Dritzz7/hardware-dosimeter/jlcpcb/WBV_20261011_R2/WBV_JLC_BOM.csv

Comment | Designator | Footprint | LCSC Part #
1060TR | BT1 | BatteryHolder_Keystone_1060TR_1x2032 | C238069
CL31A226KOHNNNE | C1 | C_1206_3216Metric | C90146
C0805C104K5RACTU | C2,C4,C5,C7,C10,C11,C12,C13,C14,C16,C18,C20,C21,C22,C24 | C_0805_2012Metric | C3018562
C0805C105K4RACTU | C3,C6 | C_0805_2012Metric | C2167376
CL21A106KAYNNNE | C8,C15,C23 | C_0805_2012Metric | C15850
EEUFR1E470 | C17,C19 | CP_Radial_D5.0mm_P2.00mm_H11mm_Panasonic_FR | C407893
USBLC6-4SC6 | D1,D2,D3 | SOT-23-6_USBLC6-4SC6_ST | C111212
MF-MSMF075-2 | F1 | Fuse_Bourns_MF-MSMF075_1812_Style1 | C84140
BLM21PG601SN1D | FB1 | L_0805_2012Metric | C41556732
2.54-1*6 | J1 | PinHeader_1x06_P2.54mm_ZHOURI_1.02mm | C5156615
DM3CS-SF | J2 | microSD_Hirose_DM3CS-SF | C202111
B4B-XH-A(LF)(SN) | J3,J5 | JST_XH_B4B-XH-A_1x04_P2.50mm_Vertical | C144395
B2B-XH-A(LF)(SN) | J4 | JST_XH_B2B-XH-A_1x02_P2.50mm_Vertical | C158012
RC0805FR-0710KL | R1,R2,R11,R12,R13,R14,R15,R16,R19 | R_0805_2012Metric | C84376
RC0805FR-07499RL | R3 | R_0805_2012Metric | C130458
RC0805FR-0733RL | R8,R9,R10 | R_0805_2012Metric | C126353
RC0805FR-074K7L | R17,R18 | R_0805_2012Metric | C60816
RC0805FR-071KL | R20 | R_0805_2012Metric | C95781
RC0805FR-07330KL | R21 | R_0805_2012Metric | C114528
RC0805FR-07100KL | R22 | R_0805_2012Metric | C96346
B3F-1000 | SW1,SW2,SW3 | SW_PUSH_6mm_H4.3mm | C93157
ESP32-WROOM-32E-N4 | U1 | ESP32-WROOM-32E_JLC_NoVia | C701341
ADXL345BCCZ-RL7 | U2 | ADXL345_CC-14-1_ADI_JLC | C9667
DS3231SN# | U3 | SOIC-16W_7.5x10.3mm_P1.27mm | C5369307
