Dritzz7/hardware-dosimeter/jlcpcb/WBV_20261011_R2/WBV_Assembly_Top.png

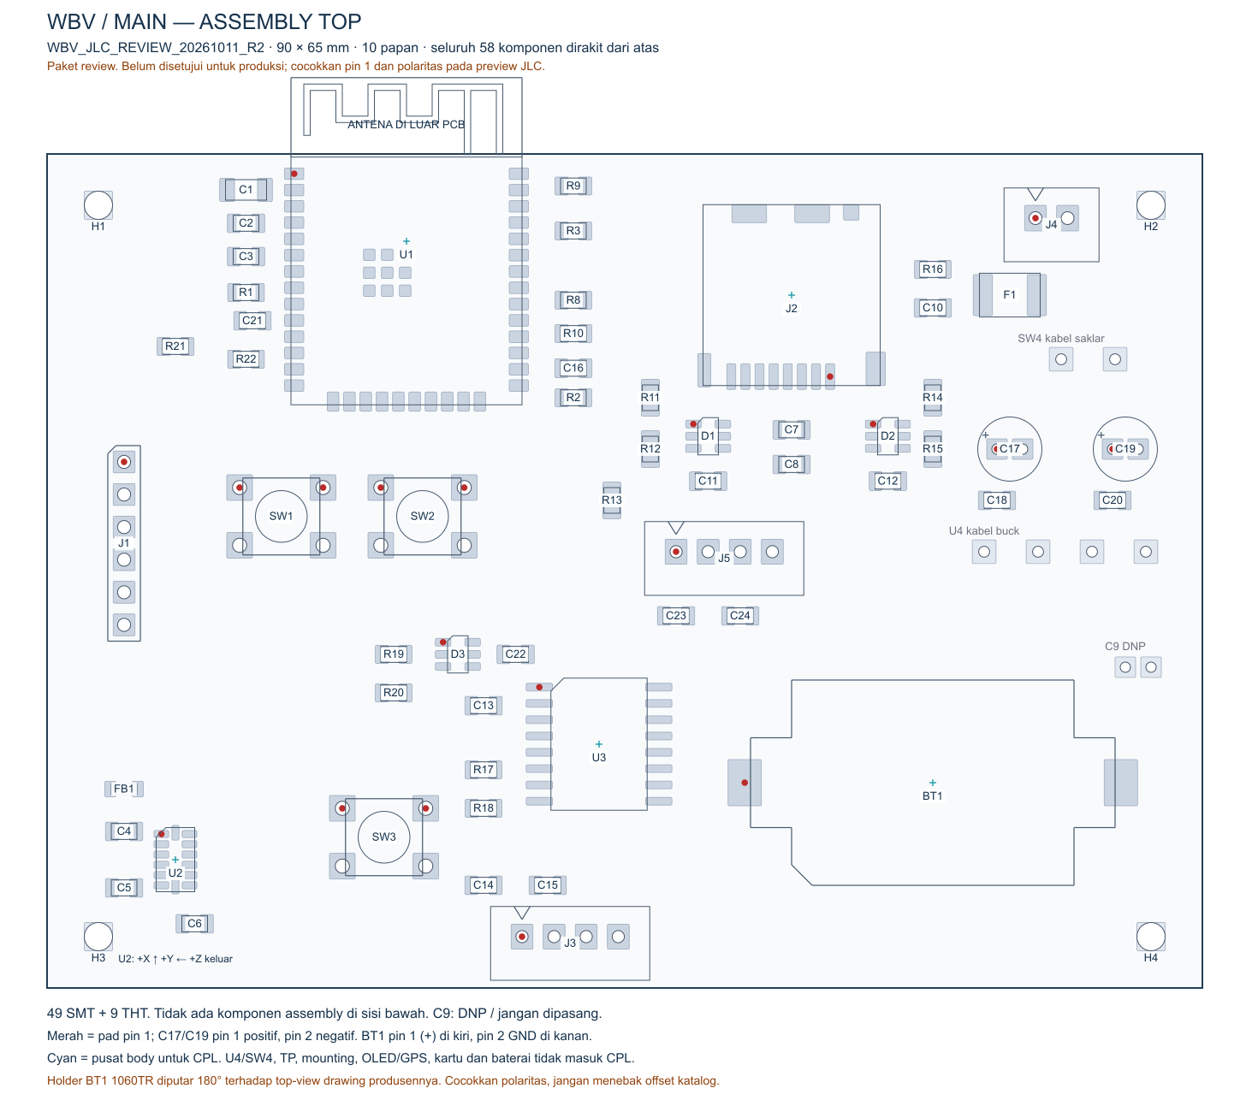
jlcpcb/WBV_20261011_R2/WBV_Assembly_Top.png
