Dritzz7/hardware-dosimeter/main_unit/main_unit.kicad_pcb

## KiCad design main_unit/main_unit.kicad_pcb (2026-10-11)

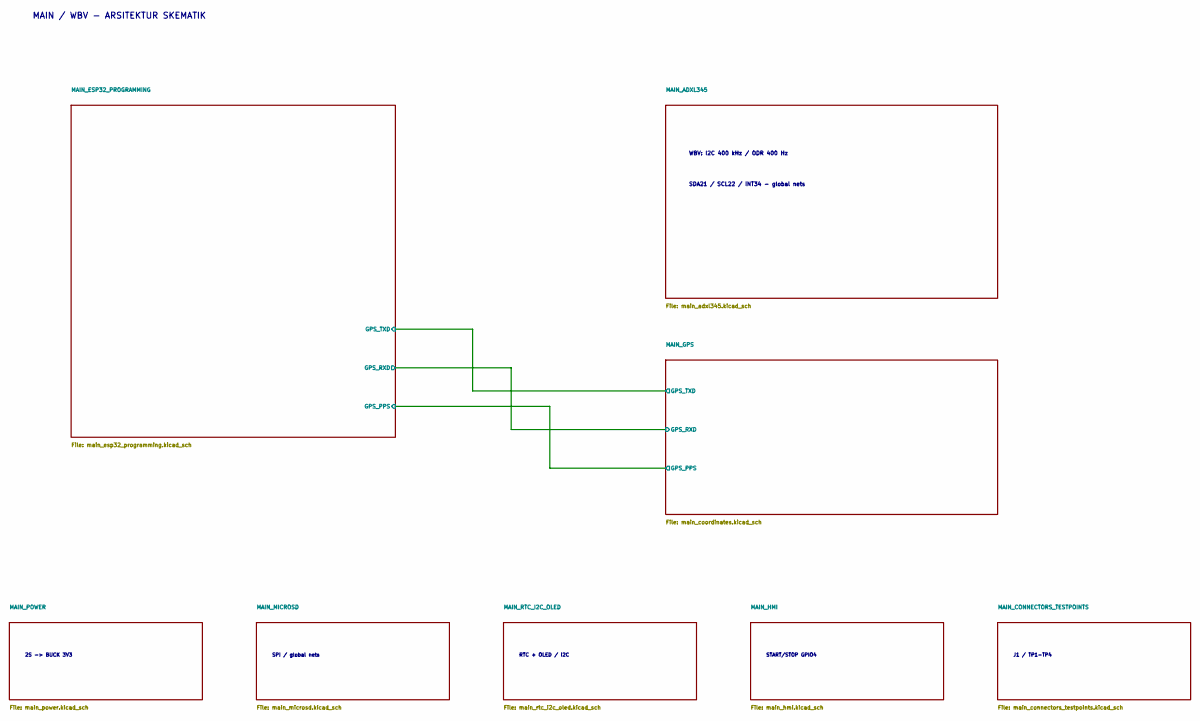
[picture p2: schematic main_unit.kicad_sch, MAIN ROOT - WBV + GPS]

Notes on the sheet:
2S -> BUCK 3V3
MAIN / WBV - ARSITEKTUR SKEMATIK
SPI / global nets
RTC + OLED / I2C
WBV: I2C 400 kHz / ODR 400 Hz
START/STOP GPIO4
SDA21 / SCL22 / INT34 - global nets
J1 / TP1-TP4

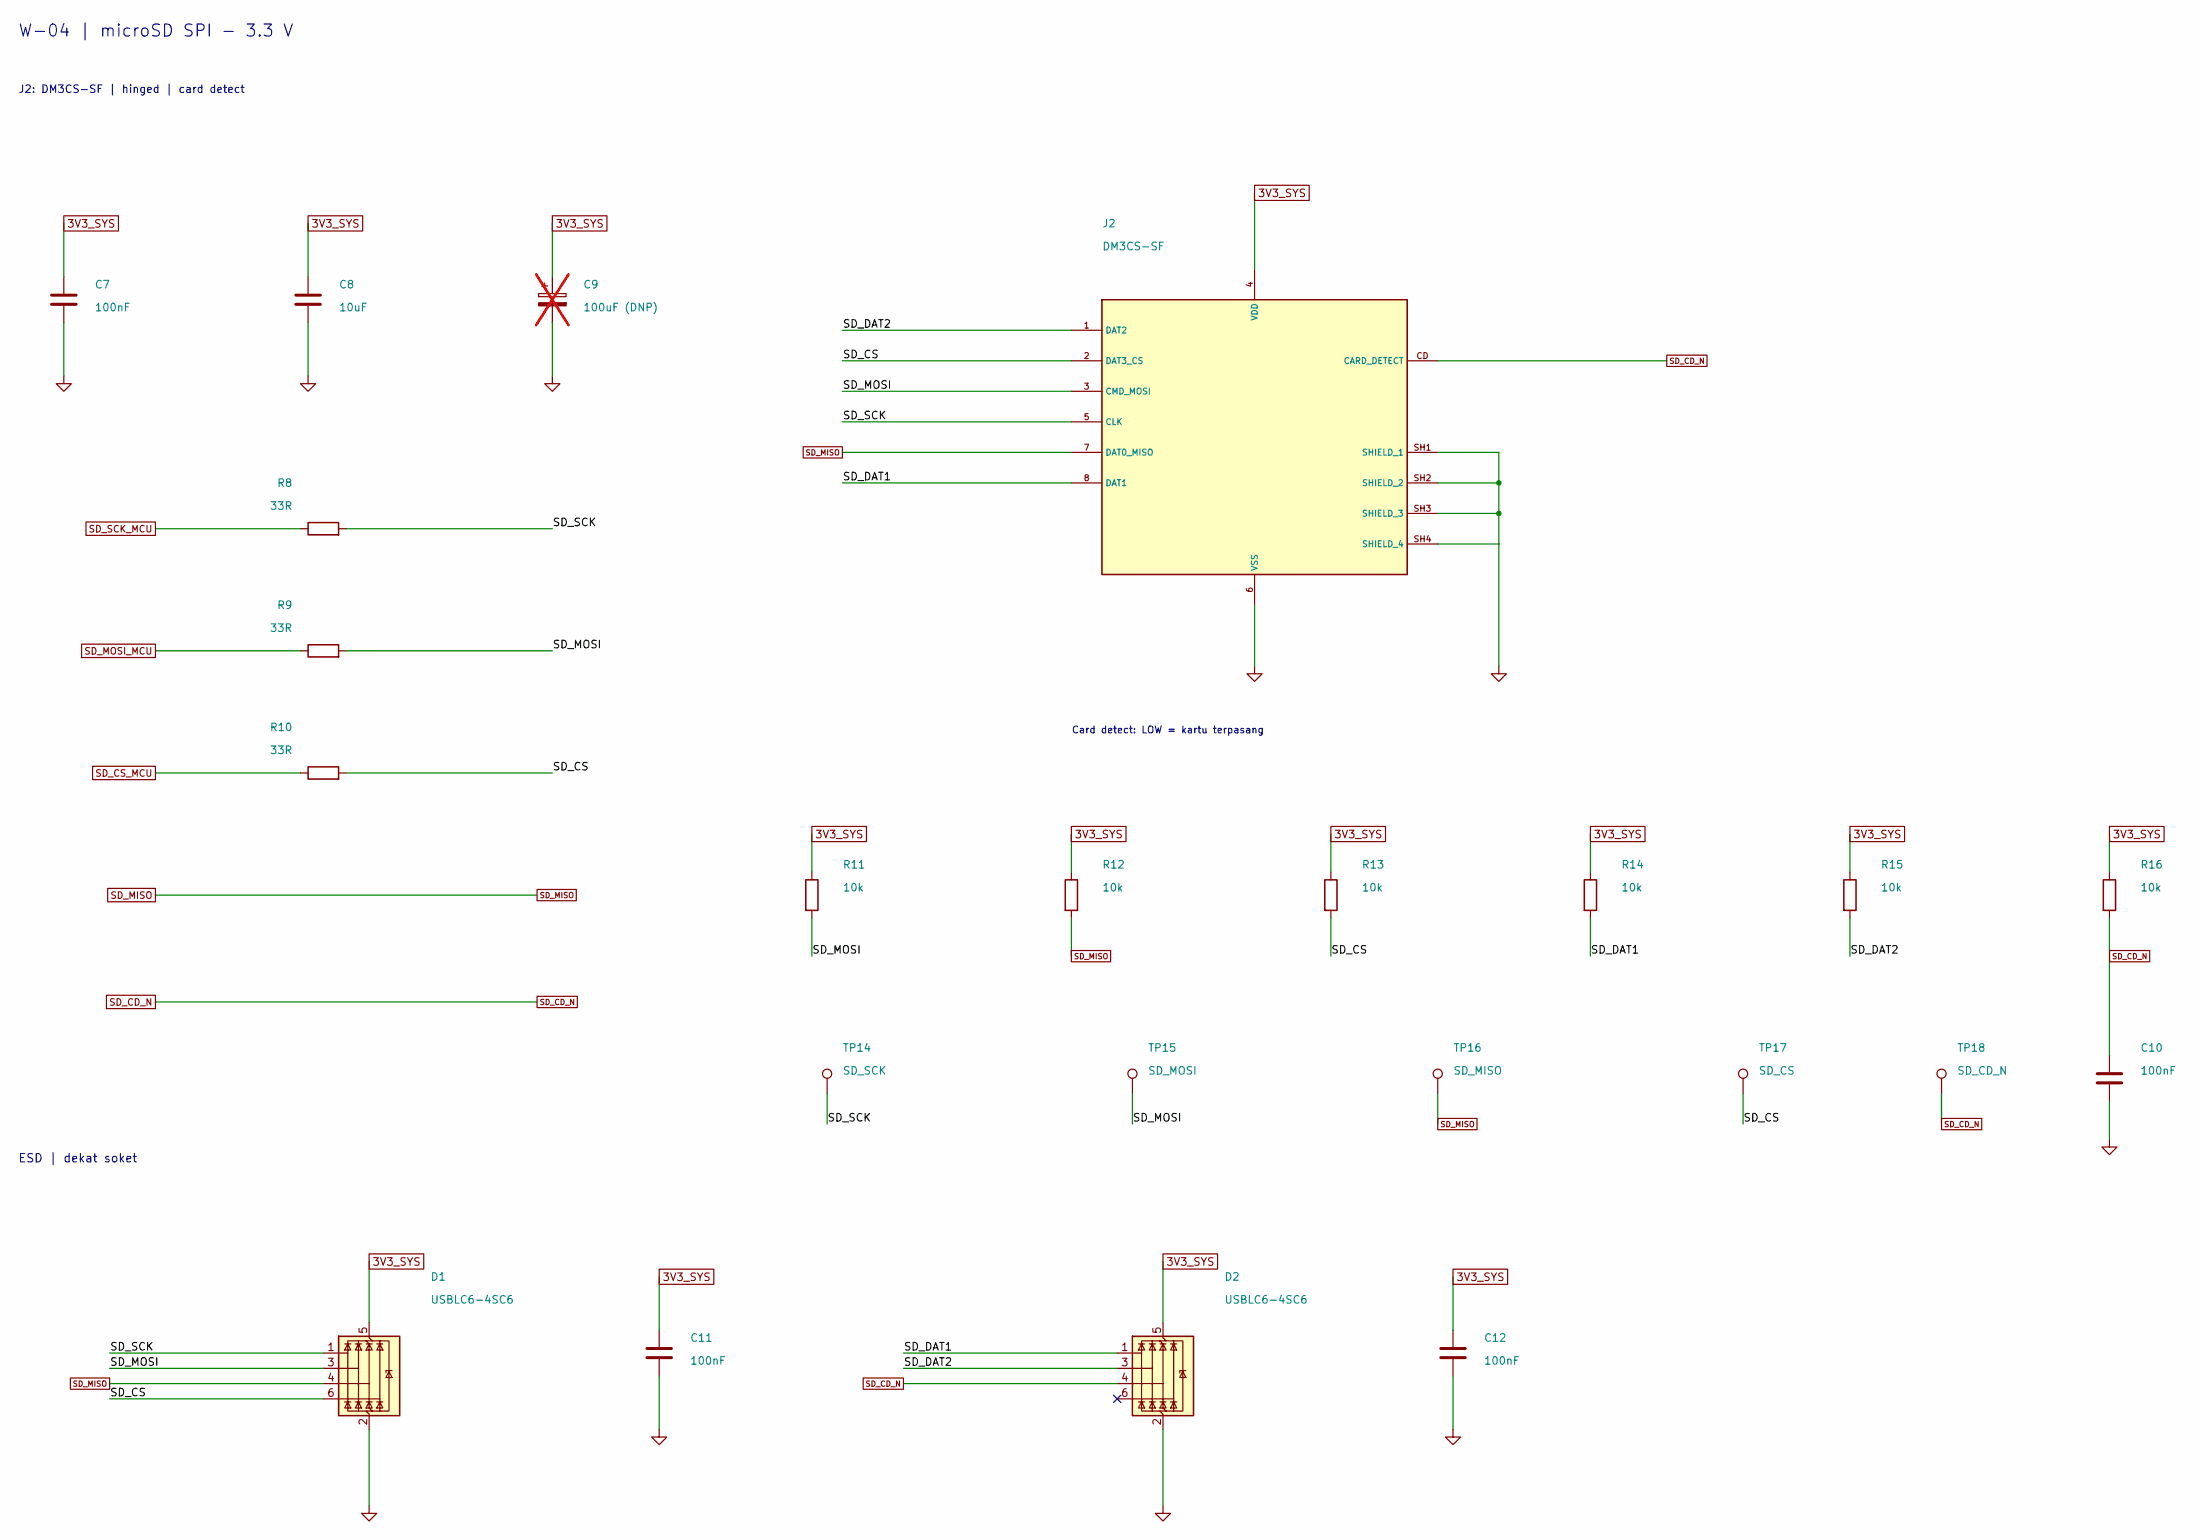
[picture p3: schematic main_microsd.kicad_sch, MAIN microSD - SPI]

Parts:
C7, C10, C11, C12: 100nF; C_0805_2012Metric; MPN C0805C104K5RACTU; LCSC Part # C3018562
C8: 10uF; C_0805_2012Metric; MPN CL21A106KAYNNNE; LCSC Part # C15850
C9: 100uF (DNP); CP_Radial_D5.0mm_P2.00mm_H11mm_Panasonic_FR; MPN EEUFR1C101; not fitted
D1, D2: USBLC6-4SC6; SOT-23-6_USBLC6-4SC6_ST; MPN USBLC6-4SC6; LCSC Part # C111212
J2: DM3CS-SF; microSD_Hirose_DM3CS-SF; MPN DM3CS-SF; LCSC Part # C202111
R8, R9, R10: 33R; R_0805_2012Metric; MPN RC0805FR-0733RL; LCSC Part # C126353
R11, R12, R13, R14, R15, R16: 10k; R_0805_2012Metric; MPN RC0805FR-0710KL; LCSC Part # C84376
TP14: SD_SCK; TestPoint_Pad_D1.5mm; MPN N/A - PCB copper feature
TP15: SD_MOSI; TestPoint_Pad_D1.5mm; MPN N/A - PCB copper feature
TP16: SD_MISO; TestPoint_Pad_D1.5mm; MPN N/A - PCB copper feature
TP17: SD_CS; TestPoint_Pad_D1.5mm; MPN N/A - PCB copper feature
TP18: SD_CD_N; TestPoint_Pad_D1.5mm; MPN N/A - PCB copper feature

Connections:
3V3_SYS: C7.1, C8.1, C9.1, C11.1, C12.1, D1.5 (VBUS), D2.5 (VBUS), J2.4 (VDD), R11.1, R12.1, R13.1, R14.1, R15.1, R16.1; also elsewhere on the board
/MAIN_MICROSD/SD_CS: D1.6 (I/O4), J2.2 (DAT3_CS), R10.2, R13.2, TP17.1 (1_1)
/MAIN_MICROSD/SD_DAT1: D2.1 (I/O1), J2.8 (DAT1), R14.2
/MAIN_MICROSD/SD_DAT2: D2.3 (I/O2), J2.1 (DAT2), R15.2
/MAIN_MICROSD/SD_MOSI: D1.3 (I/O2), J2.3 (CMD_MOSI), R9.2, R11.2, TP15.1 (1_1)
/MAIN_MICROSD/SD_SCK: D1.1 (I/O1), J2.5 (CLK), R8.2, TP14.1 (1_1)
GND: C7.2, C8.2, C9.2, C10.2, C11.2, C12.2, D1.2 (GND), D2.2 (GND), J2.6 (VSS), J2.SH1 (SHIELD_1), J2.SH2 (SHIELD_2), J2.SH3 (SHIELD_3), J2.SH4 (SHIELD_4); also elsewhere on the board
SD_CD_N: C10.1, D2.4 (I/O3), J2.CD (CARD_DETECT), R16.2, TP18.1 (1_1); also elsewhere on the board
SD_CS_MCU: R10.1; also elsewhere on the board
SD_MISO: D1.4 (I/O3), J2.7 (DAT0_MISO), R12.2, TP16.1 (1_1); also elsewhere on the board
SD_MOSI_MCU: R9.1; also elsewhere on the board
SD_SCK_MCU: R8.1; also elsewhere on the board

Notes on the sheet:
Card detect: LOW = kartu terpasang
ESD | dekat soket
W-04 | microSD SPI - 3.3 V
J2: DM3CS-SF | hinged | card detect

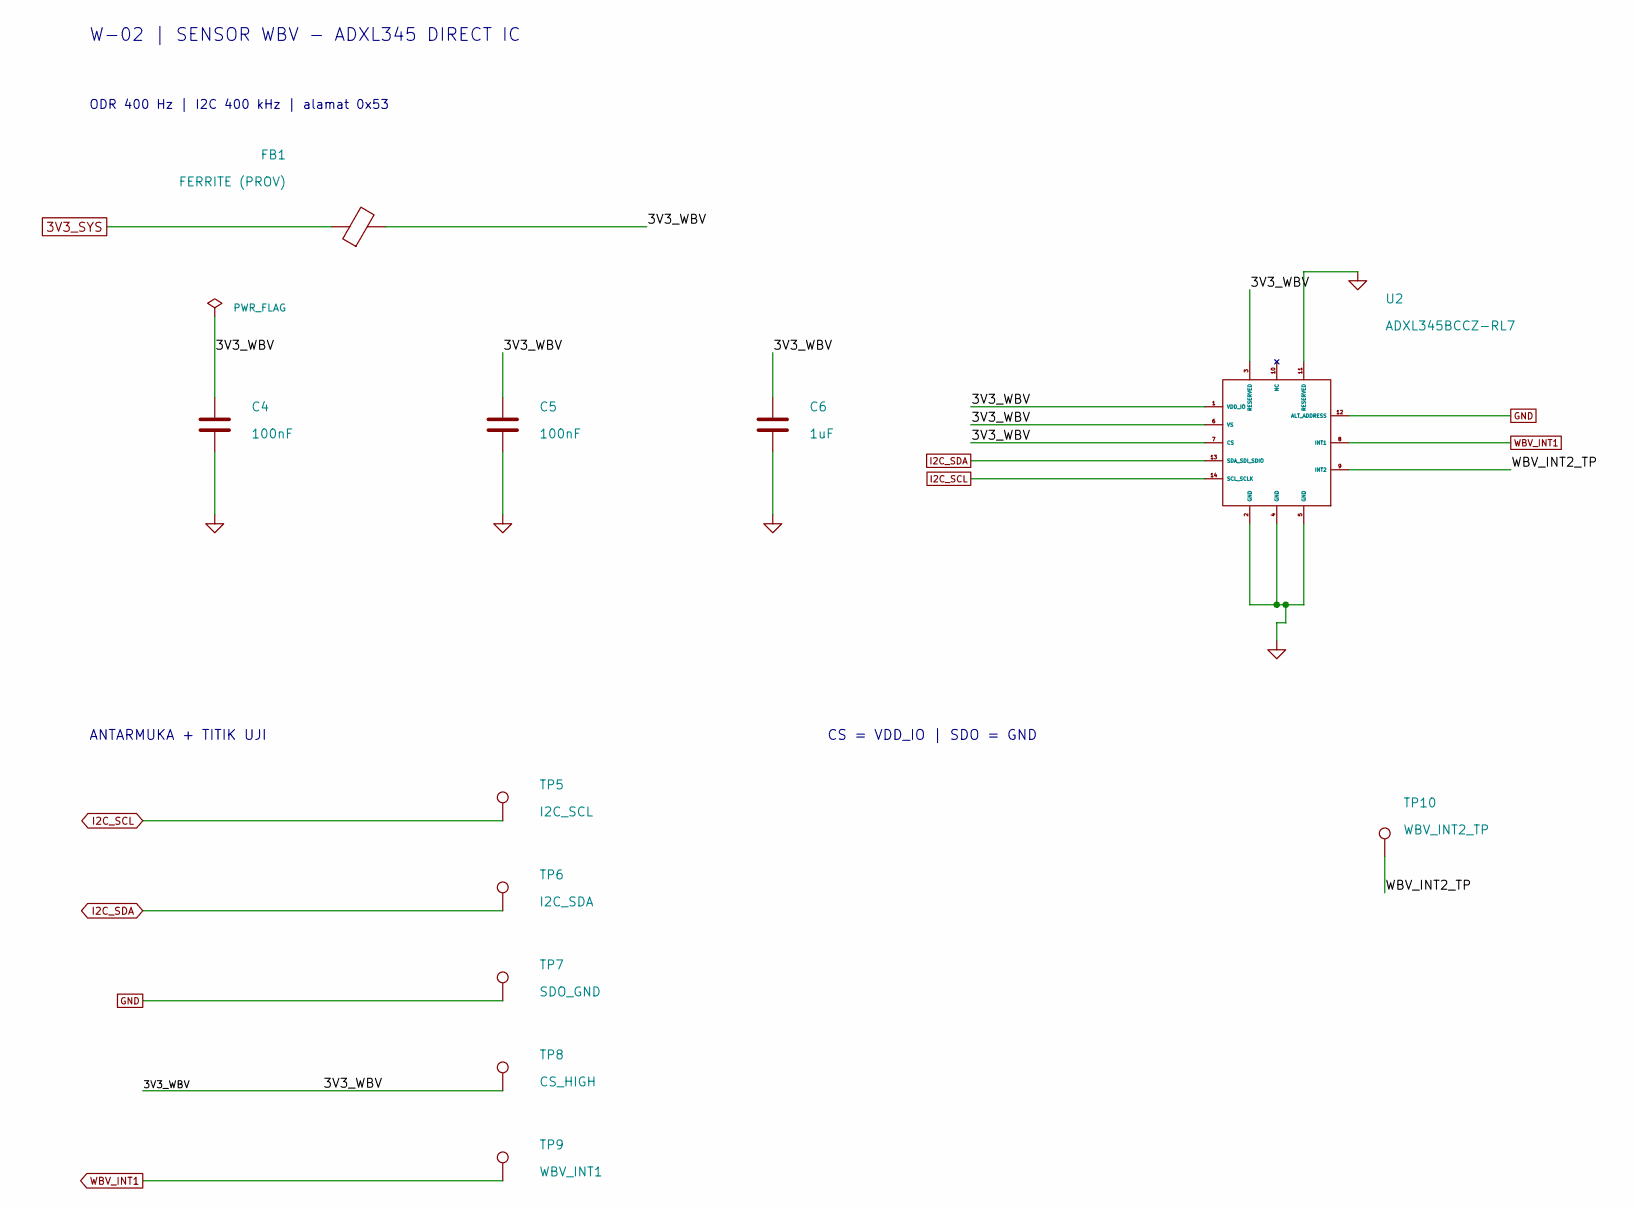
[picture p4: schematic main_adxl345.kicad_sch, MAIN WBV - ADXL345 400 Hz]

Parts:
C4, C5: 100nF; C_0805_2012Metric; MPN C0805C104K5RACTU; LCSC Part # C3018562
C6: 1uF; C_0805_2012Metric; MPN C0805C105K4RACTU; LCSC Part # C2167376
FB1: FERRITE (PROV); L_0805_2012Metric; MPN BLM21PG601SN1D; LCSC Part # C41556732
TP5: I2C_SCL; TestPoint_Pad_D1.5mm; MPN N/A - PCB copper feature
TP6: I2C_SDA; TestPoint_Pad_D1.5mm; MPN N/A - PCB copper feature
TP7: SDO_GND; TestPoint_Pad_D1.5mm; MPN N/A - PCB copper feature
TP8: CS_HIGH; TestPoint_Pad_D1.5mm; MPN N/A - PCB copper feature
TP9: WBV_INT1; TestPoint_Pad_D1.5mm; MPN N/A - PCB copper feature
TP10: WBV_INT2_TP; TestPoint_Pad_D1.5mm; MPN N/A - PCB copper feature
U2: ADXL345BCCZ-RL7; ADXL345_CC-14-1_ADI_JLC; MPN ADXL345BCCZ-RL7; LCSC Part # C9667

Connections:
3V3_SYS: FB1.1; also elsewhere on the board
/MAIN_ADXL345/3V3_WBV: C4.1, C5.1, C6.1, FB1.2, TP8.1 (1_1), U2.1 (VDD_IO), U2.3 (RESERVED), U2.6 (VS), U2.7 (CS)
/MAIN_ADXL345/WBV_INT2_TP: TP10.1 (1_1), U2.9 (INT2)
GND: C4.2, C5.2, C6.2, TP7.1 (1_1), U2.2 (GND), U2.4 (GND), U2.5 (GND), U2.11 (RESERVED), U2.12 (ALT_ADDRESS); also elsewhere on the board
I2C_SCL: TP5.1 (1_1), U2.14 (SCL_SCLK); also elsewhere on the board
I2C_SDA: TP6.1 (1_1), U2.13 (SDA_SDI_SDIO); also elsewhere on the board
WBV_INT1: TP9.1 (1_1), U2.8 (INT1); also elsewhere on the board

Notes on the sheet:
W-02 | SENSOR WBV - ADXL345 DIRECT IC
ODR 400 Hz | I2C 400 kHz | alamat 0x53
ANTARMUKA + TITIK UJI
CS = VDD_IO | SDO = GND

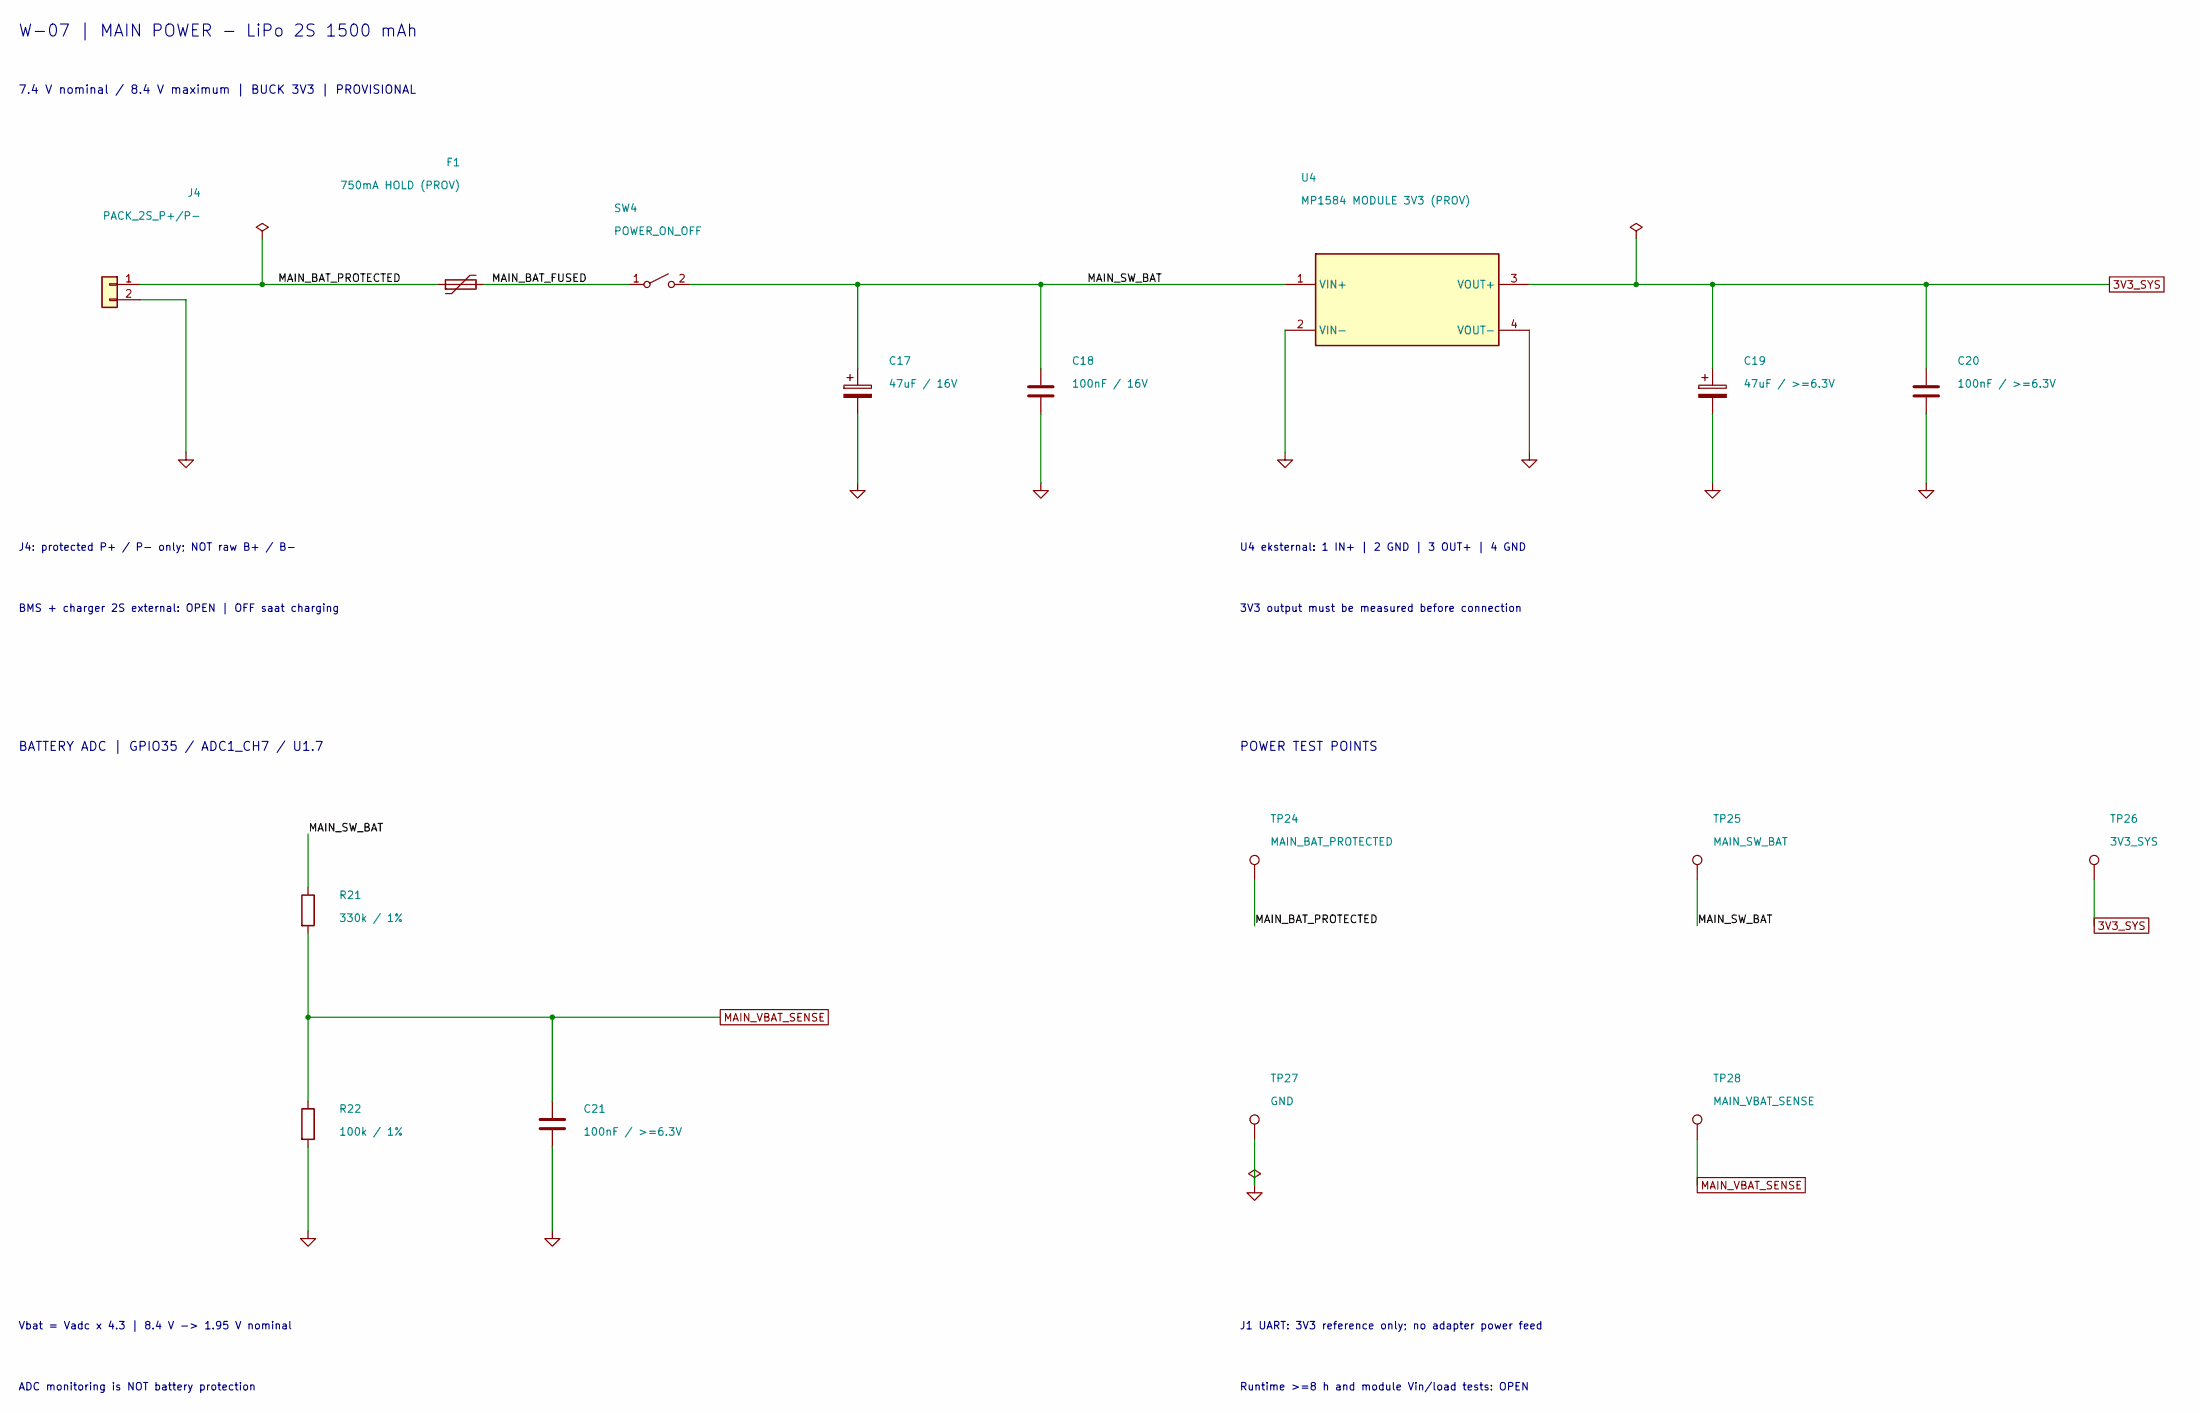
[picture p5: schematic main_power.kicad_sch, MAIN POWER - 2S BUCK]

Parts:
C17: 47uF / 16V; CP_Radial_D5.0mm_P2.00mm_H11mm_Panasonic_FR; MPN EEUFR1E470; LCSC Part # C407893
C18: 100nF / 16V; C_0805_2012Metric; MPN C0805C104K5RACTU; LCSC Part # C3018562
C19: 47uF / >=6.3V; CP_Radial_D5.0mm_P2.00mm_H11mm_Panasonic_FR; MPN EEUFR1E470; LCSC Part # C407893
C20, C21: 100nF / >=6.3V; C_0805_2012Metric; MPN C0805C104K5RACTU; LCSC Part # C3018562
F1: 750mA HOLD (PROV); Fuse_Bourns_MF-MSMF075_1812_Style1; MPN MF-MSMF075-2; LCSC Part # C84140
J4: PACK_2S_P+/P-; JST_XH_B2B-XH-A_1x02_P2.50mm_Vertical; MPN B2B-XH-A(LF)(SN); LCSC Part # C158012
R21: 330k / 1%; R_0805_2012Metric; MPN RC0805FR-07330KL; LCSC Part # C114528
R22: 100k / 1%; R_0805_2012Metric; MPN RC0805FR-07100KL; LCSC Part # C96346
SW4: POWER_ON_OFF; SolderWire-0.25sqmm_1x02_P4.2mm_D0.65mm_OD1.7mm; MPN OPEN - verify purchased part
TP24: MAIN_BAT_PROTECTED; TestPoint_Pad_D1.5mm; MPN N/A - PCB copper feature
TP25: MAIN_SW_BAT; TestPoint_Pad_D1.5mm; MPN N/A - PCB copper feature
TP26: 3V3_SYS; TestPoint_Pad_D1.5mm; MPN N/A - PCB copper feature
TP27: GND; TestPoint_Pad_D1.5mm; MPN N/A - PCB copper feature
TP28: MAIN_VBAT_SENSE; TestPoint_Pad_D1.5mm; MPN N/A - PCB copper feature
U4: MP1584 MODULE 3V3 (PROV); SolderWire-0.25sqmm_1x04_P4.2mm_D0.65mm_OD1.7mm; MPN OPEN - verify purchased part

Connections:
3V3_SYS: C19.1, C20.1, TP26.1 (1_1), U4.3 (VOUT+); also elsewhere on the board
/MAIN_POWER/MAIN_BAT_FUSED: F1.2, SW4.1 (A)
/MAIN_POWER/MAIN_BAT_PROTECTED: F1.1, J4.1, TP24.1 (1_1)
/MAIN_POWER/MAIN_SW_BAT: C17.1, C18.1, R21.1, SW4.2 (B), TP25.1 (1_1), U4.1 (VIN+)
GND: C17.2, C18.2, C19.2, C20.2, C21.2, J4.2, R22.2, TP27.1 (1_1), U4.2 (VIN-), U4.4 (VOUT-); also elsewhere on the board
MAIN_VBAT_SENSE: C21.1, R21.2, R22.1, TP28.1 (1_1); also elsewhere on the board

Notes on the sheet:
ADC monitoring is NOT battery protection
POWER TEST POINTS
Vbat = Vadc x 4.3 | 8.4 V -> 1.95 V nominal
Runtime >=8 h and module Vin/load tests: OPEN
J1 UART: 3V3 reference only; no adapter power feed
3V3 output must be measured before connection
U4 eksternal: 1 IN+ | 2 GND | 3 OUT+ | 4 GND
J4: protected P+ / P- only; NOT raw B+ / B-
7.4 V nominal / 8.4 V maximum | BUCK 3V3 | PROVISIONAL
BMS + charger 2S external: OPEN | OFF saat charging
W-07 | MAIN POWER - LiPo 2S 1500 mAh
BATTERY ADC | GPIO35 / ADC1_CH7 / U1.7

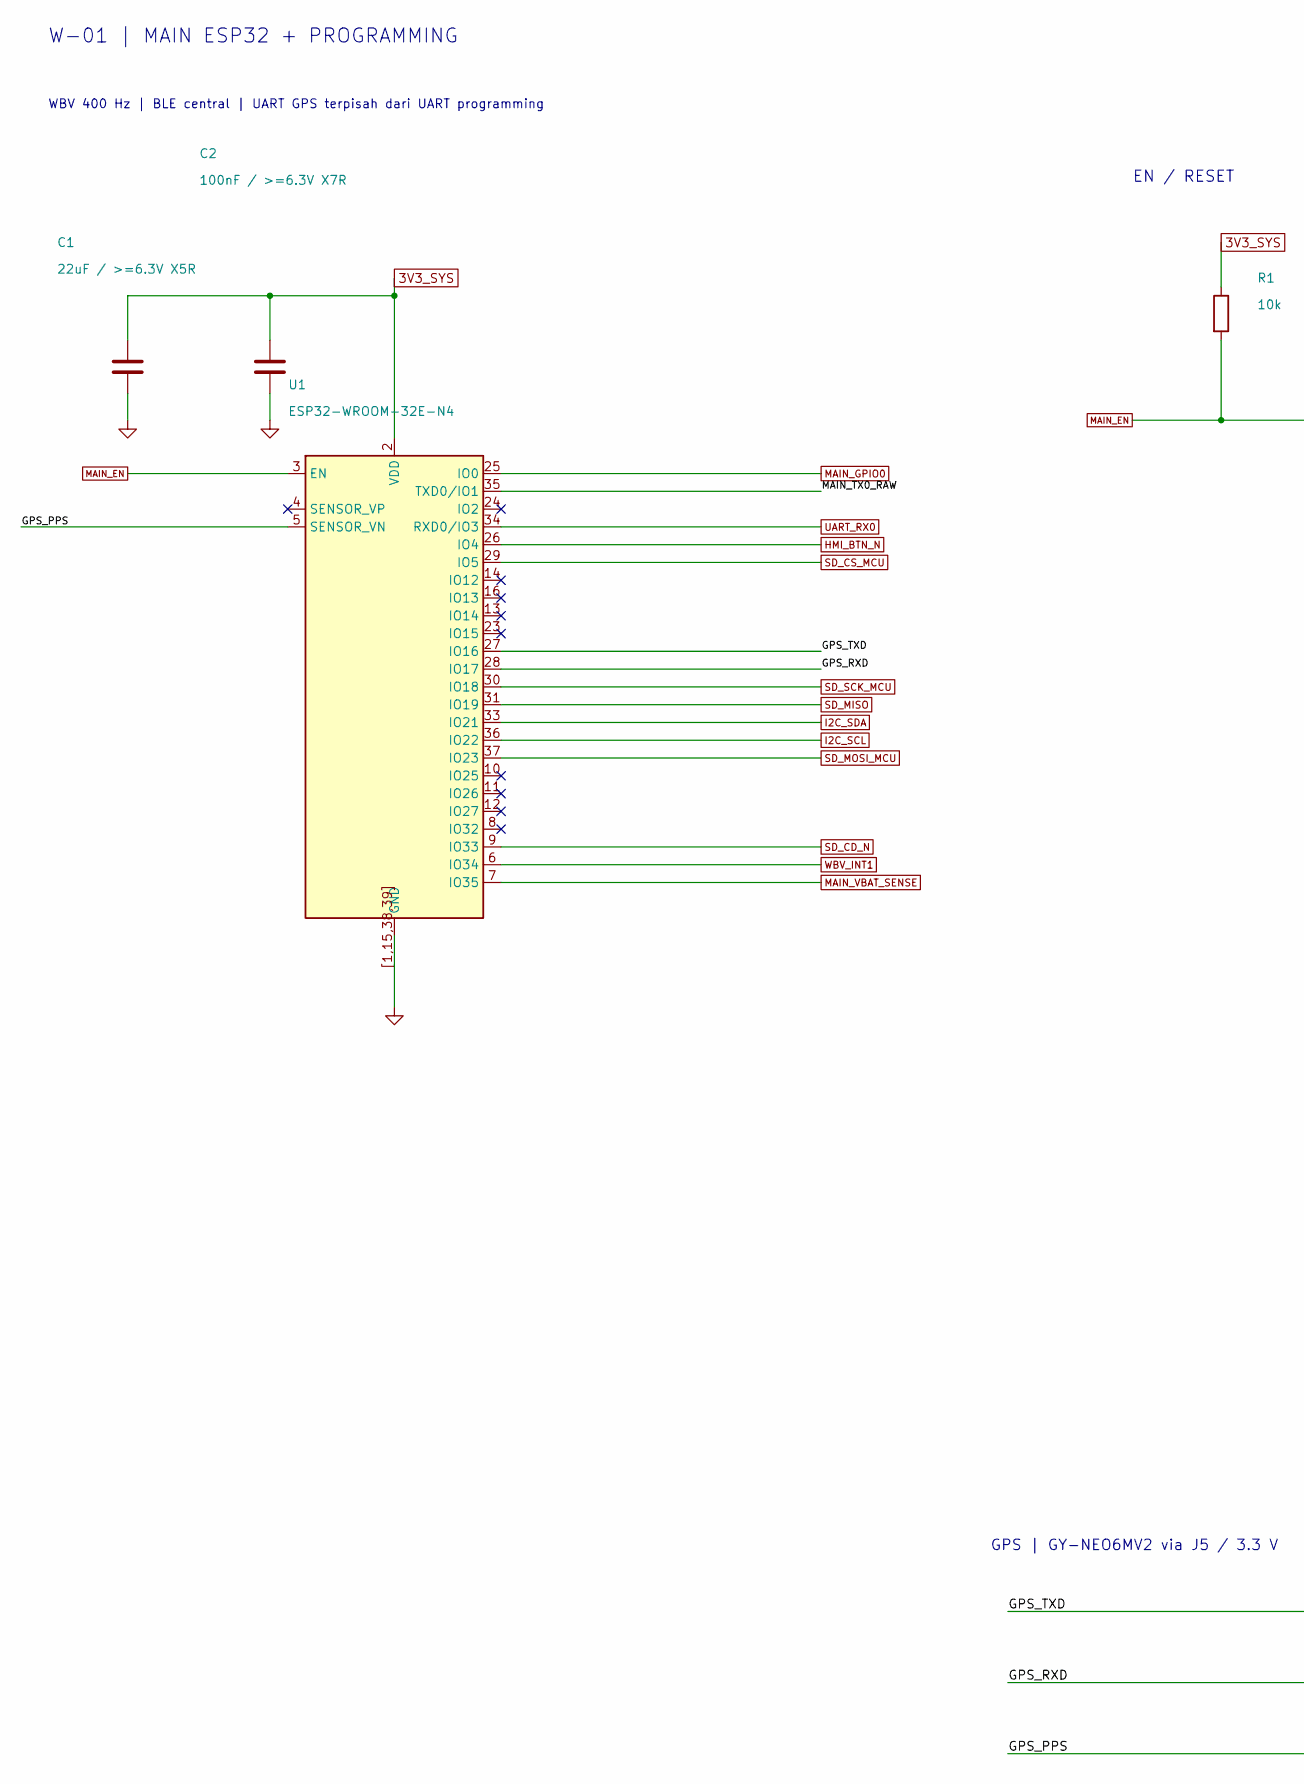
[picture p6: schematic main_esp32_programming.kicad_sch, MAIN ESP32 - RESET - BOOT - UART, part in row 1, column 1]

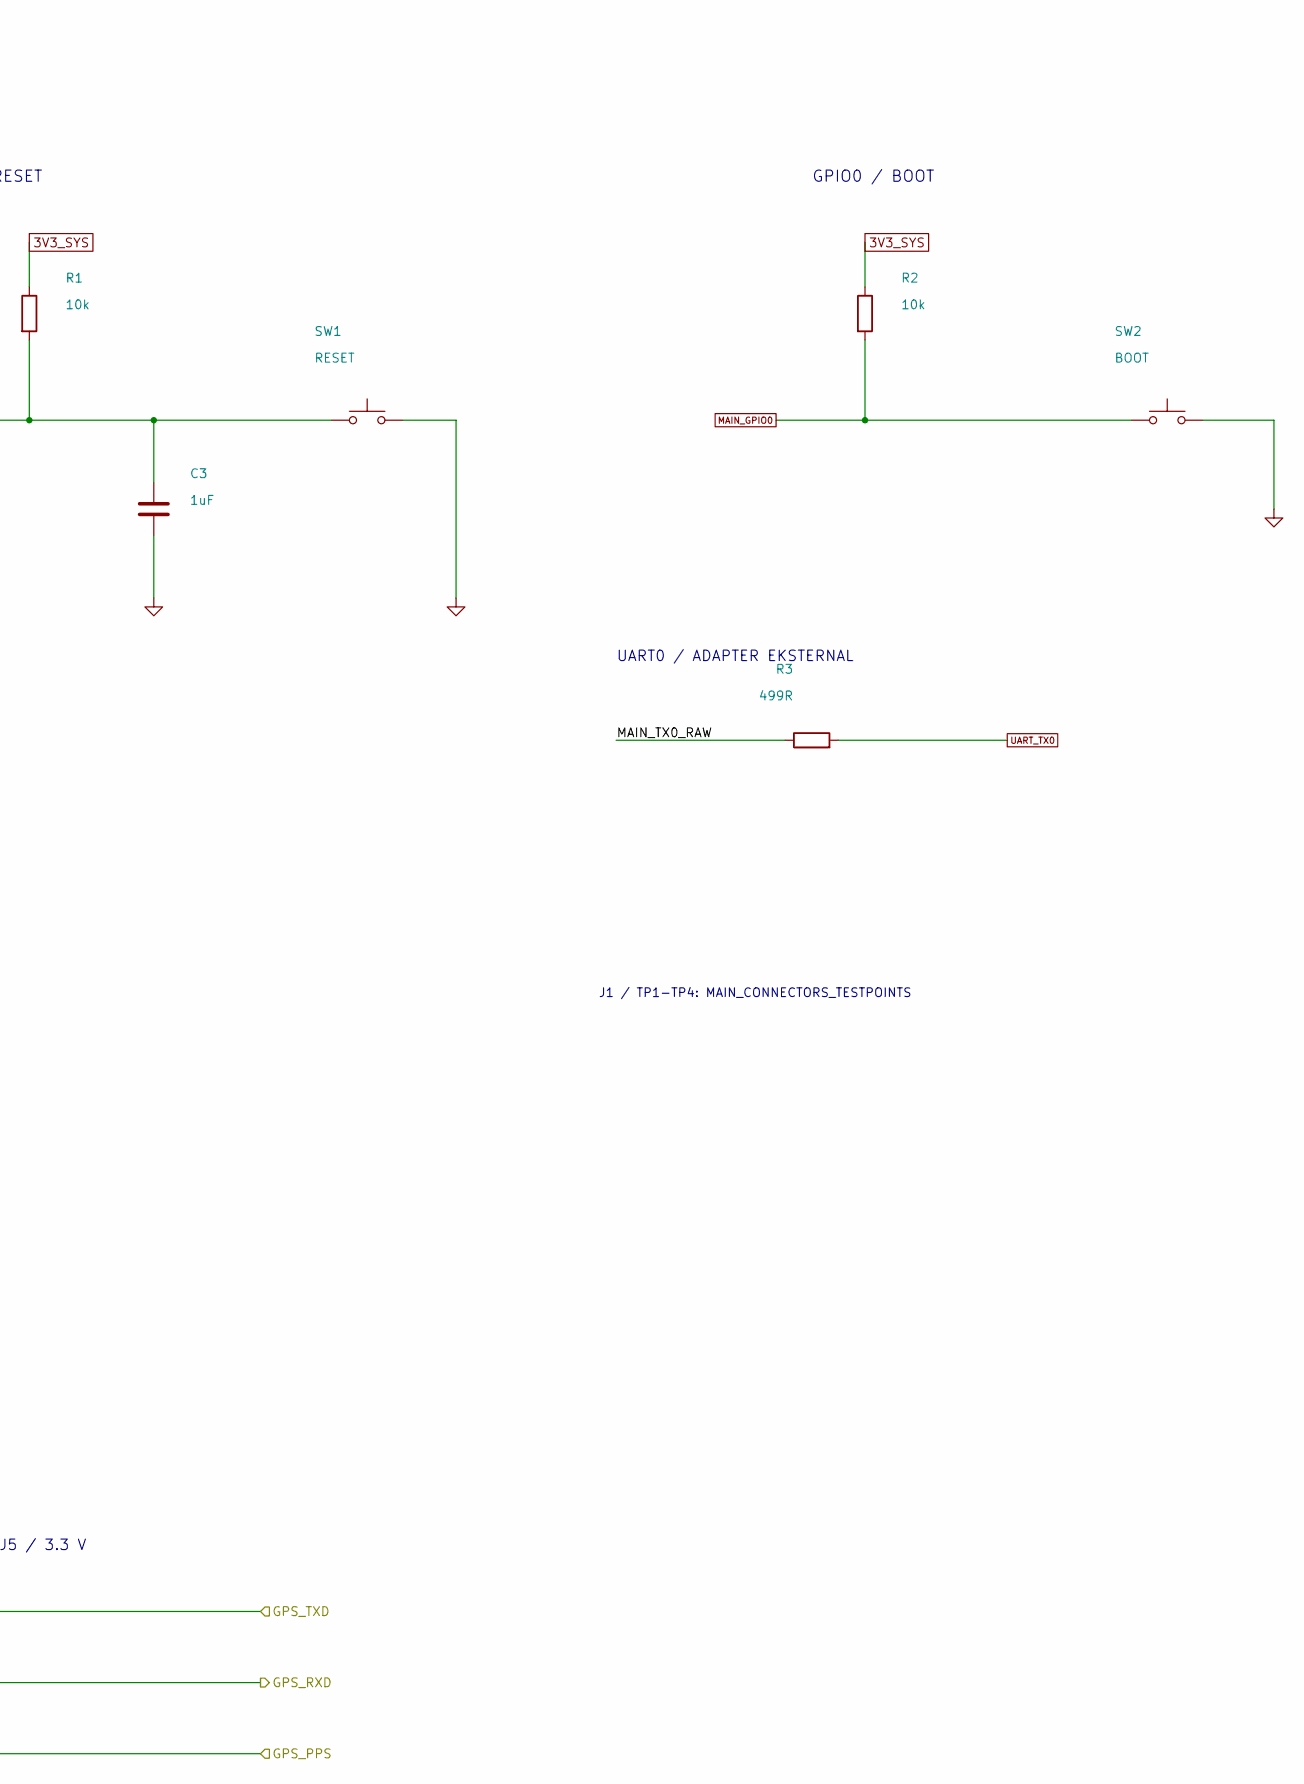
[picture p7: schematic main_esp32_programming.kicad_sch, MAIN ESP32 - RESET - BOOT - UART, part in row 1, column 2]

Parts:
C1: 22uF / >=6.3V X5R; C_1206_3216Metric; MPN CL31A226KOHNNNE; LCSC Part # C90146
C2: 100nF / >=6.3V X7R; C_0805_2012Metric; MPN C0805C104K5RACTU; LCSC Part # C3018562
C3: 1uF; C_0805_2012Metric; MPN C0805C105K4RACTU; LCSC Part # C2167376
R1, R2: 10k; R_0805_2012Metric; MPN RC0805FR-0710KL; LCSC Part # C84376
R3: 499R; R_0805_2012Metric; MPN RC0805FR-07499RL; LCSC Part # C130458
SW1: RESET; SW_PUSH_6mm_H4.3mm; MPN B3F-1000; LCSC Part # C93157
SW2: BOOT; SW_PUSH_6mm_H4.3mm; MPN B3F-1000; LCSC Part # C93157
U1: ESP32-WROOM-32E-N4; ESP32-WROOM-32E_JLC_NoVia; MPN ESP32-WROOM-32E-N4; LCSC Part # C701341

Connections:
3V3_SYS: C1.1, C2.1, R1.1, R2.1, U1.2 (VDD); also elsewhere on the board
/MAIN_ESP32_PROGRAMMING/GPS_PPS: U1.5 (SENSOR_VN); also elsewhere on the board
/MAIN_ESP32_PROGRAMMING/GPS_RXD: U1.28 (IO17); also elsewhere on the board
/MAIN_ESP32_PROGRAMMING/GPS_TXD: U1.27 (IO16); also elsewhere on the board
/MAIN_ESP32_PROGRAMMING/MAIN_TX0_RAW: R3.1, U1.35 (TXD0/IO1)
GND: C1.2, C2.2, C3.2, SW1.2, SW2.2, U1.1 (GND), U1.15 (GND), U1.38 (GND), U1.39 (GND), U1.[1,15,38,39] (GND); also elsewhere on the board
HMI_BTN_N: U1.26 (IO4); also elsewhere on the board
I2C_SCL: U1.36 (IO22); also elsewhere on the board
I2C_SDA: U1.33 (IO21); also elsewhere on the board
MAIN_EN: C3.1, R1.2, SW1.1, U1.3 (EN); also elsewhere on the board
MAIN_GPIO0: R2.2, SW2.1, U1.25 (IO0); also elsewhere on the board
MAIN_VBAT_SENSE: U1.7 (IO35); also elsewhere on the board
SD_CD_N: U1.9 (IO33); also elsewhere on the board
SD_CS_MCU: U1.29 (IO5); also elsewhere on the board
SD_MISO: U1.31 (IO19); also elsewhere on the board
SD_MOSI_MCU: U1.37 (IO23); also elsewhere on the board
SD_SCK_MCU: U1.30 (IO18); also elsewhere on the board
UART_RX0: U1.34 (RXD0/IO3); also elsewhere on the board
UART_TX0: R3.2; also elsewhere on the board
WBV_INT1: U1.6 (IO34); also elsewhere on the board

Notes on the sheet:
W-01 | MAIN ESP32 + PROGRAMMING
GPS | GY-NEO6MV2 via J5 / 3.3 V
UART0 / ADAPTER EKSTERNAL
WBV 400 Hz | BLE central | UART GPS terpisah dari UART programming
GPIO0 / BOOT
EN / RESET
J1 / TP1-TP4: MAIN_CONNECTORS_TESTPOINTS

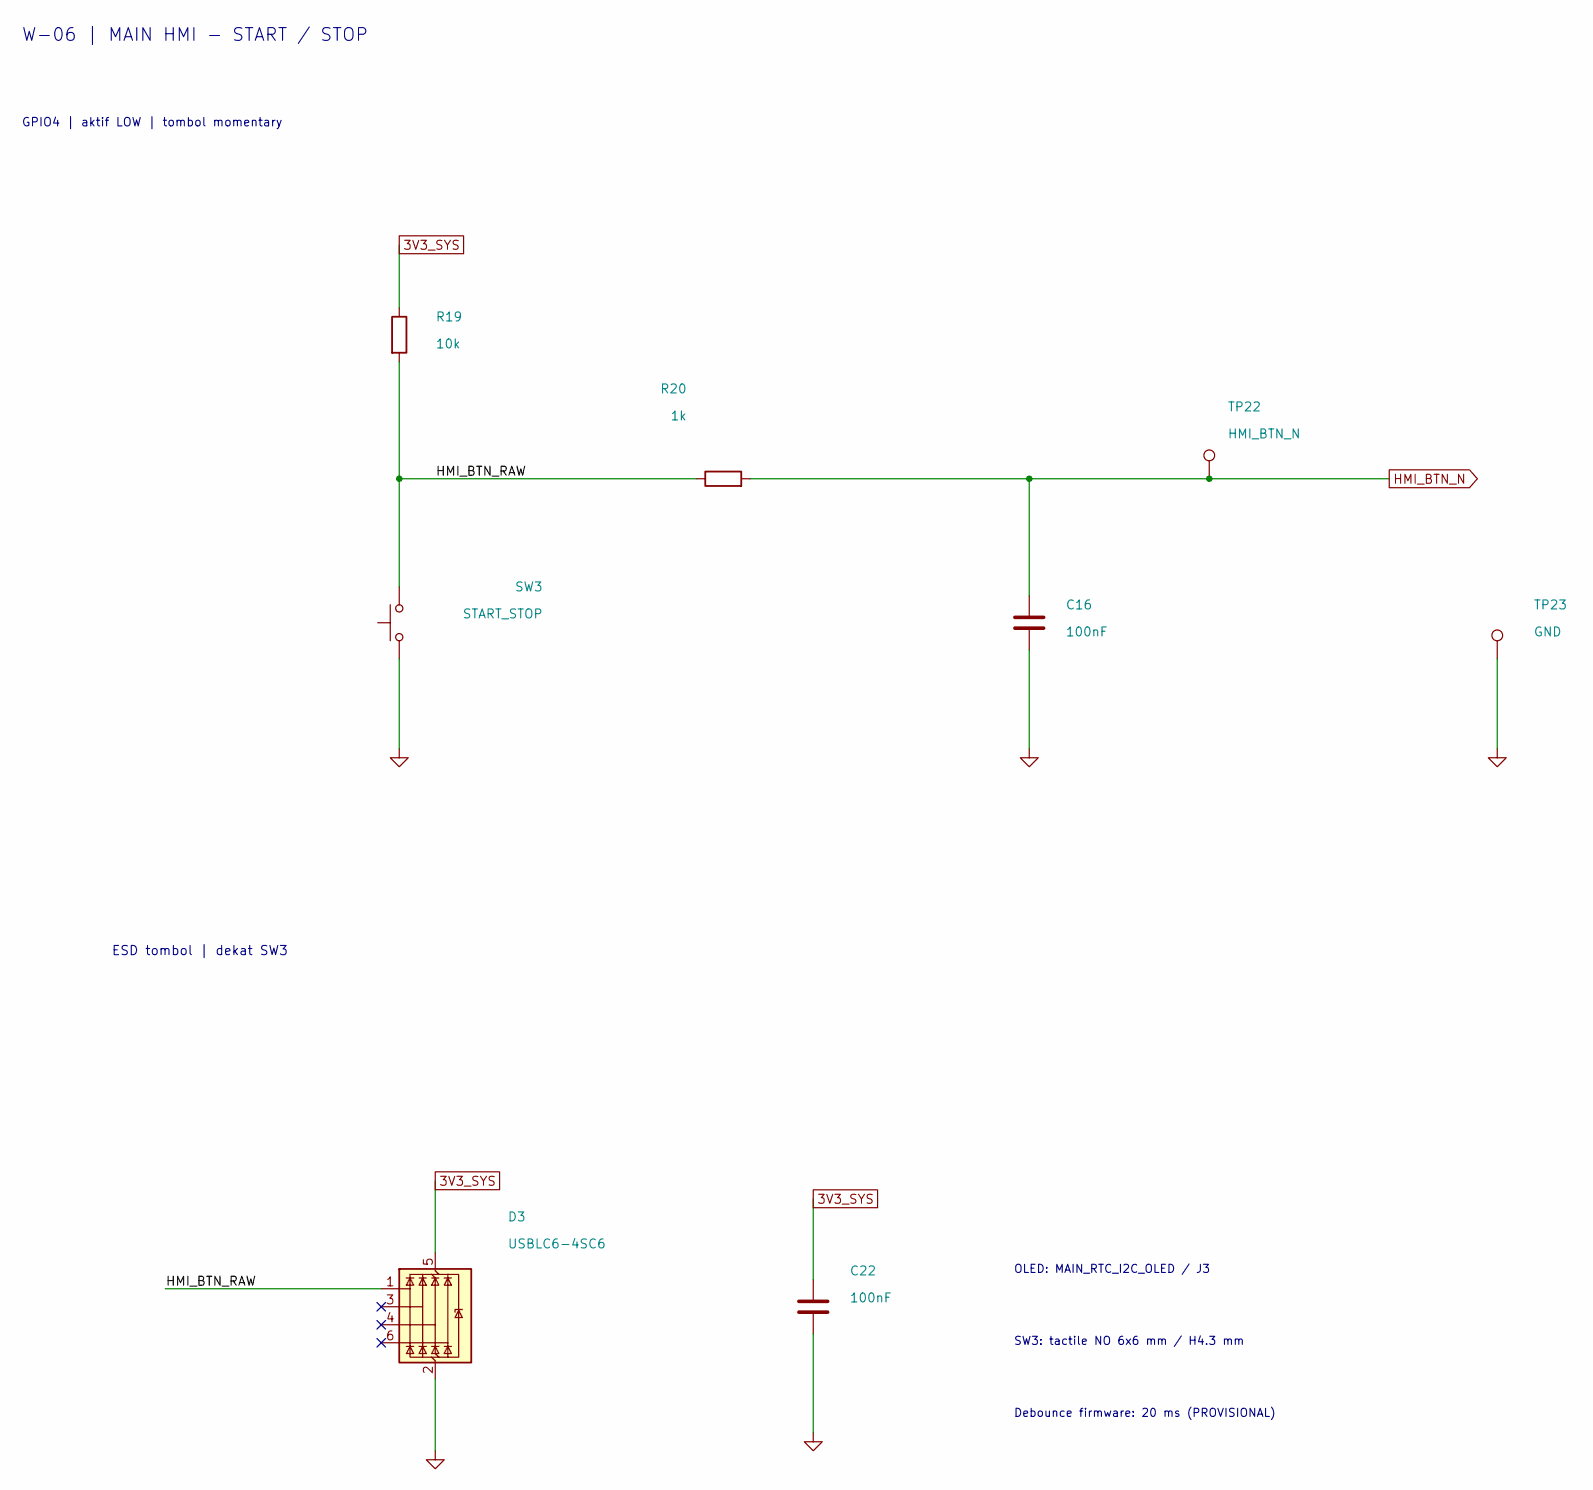
[picture p8: schematic main_hmi.kicad_sch, MAIN HMI - START STOP]

Parts:
C16, C22: 100nF; C_0805_2012Metric; MPN C0805C104K5RACTU; LCSC Part # C3018562
D3: USBLC6-4SC6; SOT-23-6_USBLC6-4SC6_ST; MPN USBLC6-4SC6; LCSC Part # C111212
R19: 10k; R_0805_2012Metric; MPN RC0805FR-0710KL; LCSC Part # C84376
R20: 1k; R_0805_2012Metric; MPN RC0805FR-071KL; LCSC Part # C95781
SW3: START_STOP; SW_PUSH_6mm_H4.3mm; MPN B3F-1000; LCSC Part # C93157
TP22: HMI_BTN_N; TestPoint_Pad_D1.5mm; MPN N/A - PCB copper feature
TP23: GND; TestPoint_Pad_D1.5mm; MPN N/A - PCB copper feature

Connections:
3V3_SYS: C22.1, D3.5 (VBUS), R19.1; also elsewhere on the board
/MAIN_HMI/HMI_BTN_RAW: D3.1 (I/O1), R19.2, R20.1, SW3.2
GND: C16.2, C22.2, D3.2 (GND), SW3.1, TP23.1 (1_1); also elsewhere on the board
HMI_BTN_N: C16.1, R20.2, TP22.1 (1_1); also elsewhere on the board

Notes on the sheet:
W-06 | MAIN HMI - START / STOP
SW3: tactile NO 6x6 mm / H4.3 mm
ESD tombol | dekat SW3
OLED: MAIN_RTC_I2C_OLED / J3
Debounce firmware: 20 ms (PROVISIONAL)
GPIO4 | aktif LOW | tombol momentary
