Dritzz7/hardware-dosimeter/main_unit/main_unit.kicad_pcb

## KiCad design main_unit/main_unit.kicad_pcb (continued)

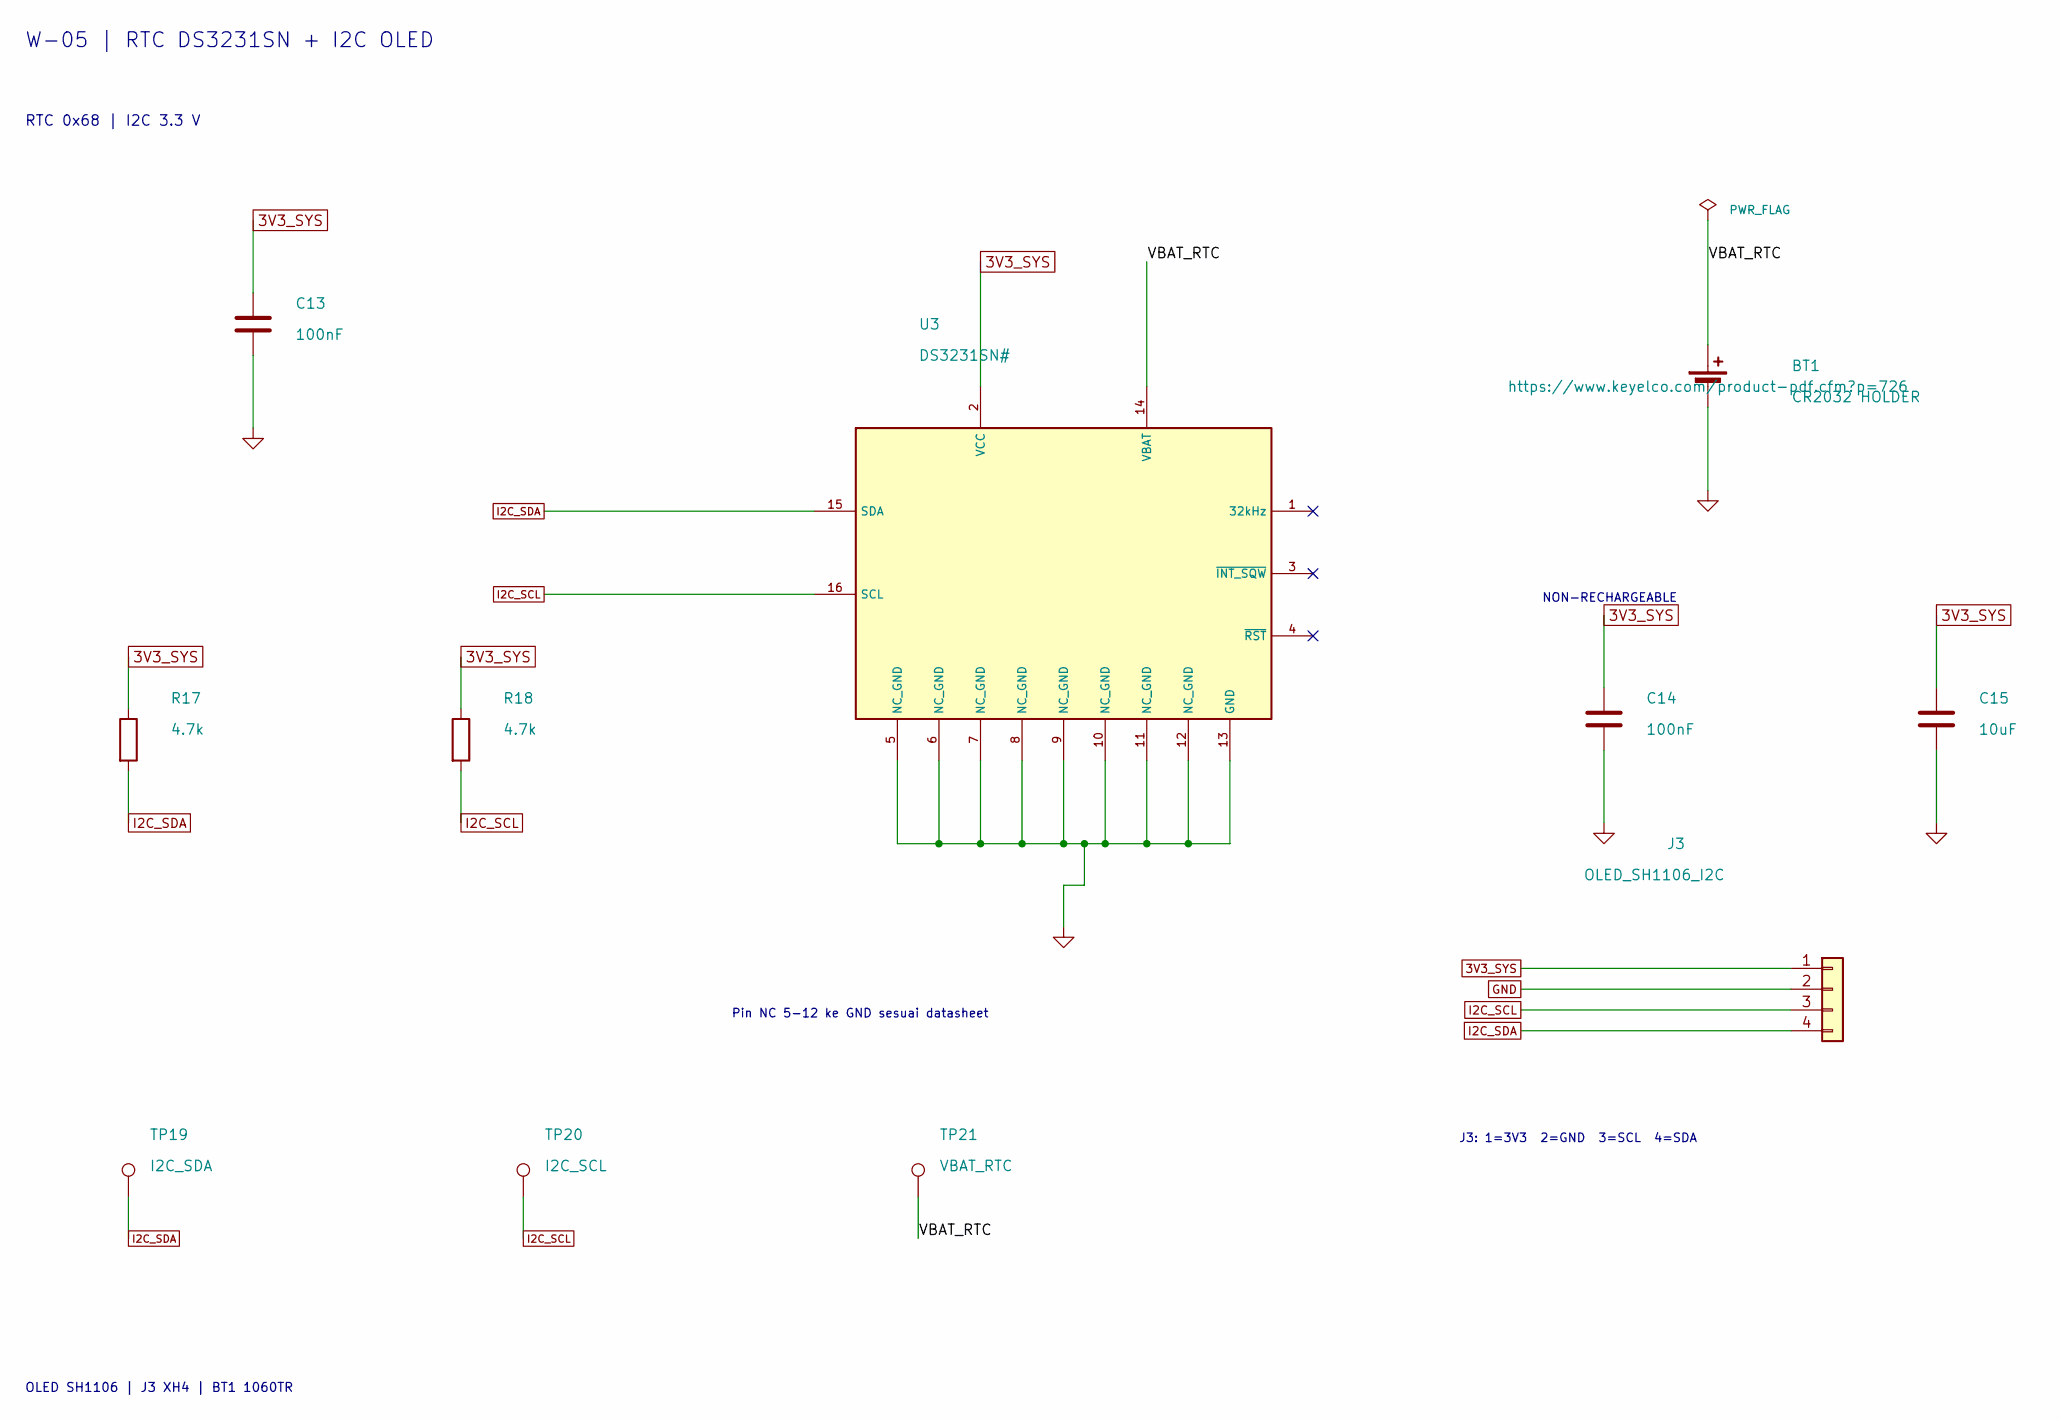
[picture p9: schematic main_rtc_i2c_oled.kicad_sch, MAIN RTC + I2C OLED]

Parts:
BT1: CR2032 HOLDER; BatteryHolder_Keystone_1060TR_1x2032; MPN 1060TR; LCSC Part # C238069
C13, C14: 100nF; C_0805_2012Metric; MPN C0805C104K5RACTU; LCSC Part # C3018562
C15: 10uF; C_0805_2012Metric; MPN CL21A106KAYNNNE; LCSC Part # C15850
J3: OLED_SH1106_I2C; JST_XH_B4B-XH-A_1x04_P2.50mm_Vertical; MPN B4B-XH-A(LF)(SN); LCSC Part # C144395
R17, R18: 4.7k; R_0805_2012Metric; MPN RC0805FR-074K7L; LCSC Part # C60816
TP19: I2C_SDA; TestPoint_Pad_D1.5mm; MPN N/A - PCB copper feature
TP20: I2C_SCL; TestPoint_Pad_D1.5mm; MPN N/A - PCB copper feature
TP21: VBAT_RTC; TestPoint_Pad_D1.5mm; MPN N/A - PCB copper feature
U3: DS3231SN#; SOIC-16W_7.5x10.3mm_P1.27mm; MPN DS3231SN#; LCSC Part # C5369307

Connections:
3V3_SYS: C13.1, C14.1, C15.1, J3.1, R17.1, R18.1, U3.2 (VCC); also elsewhere on the board
/MAIN_RTC_I2C_OLED/VBAT_RTC: BT1.1 (+), TP21.1 (1_1), U3.14 (VBAT)
GND: BT1.2 (-), C13.2, C14.2, C15.2, J3.2, U3.5 (NC_GND), U3.6 (NC_GND), U3.7 (NC_GND), U3.8 (NC_GND), U3.9 (NC_GND), U3.10 (NC_GND), U3.11 (NC_GND), U3.12 (NC_GND), U3.13 (GND); also elsewhere on the board
I2C_SCL: J3.3, R18.2, TP20.1 (1_1), U3.16 (SCL); also elsewhere on the board
I2C_SDA: J3.4, R17.2, TP19.1 (1_1), U3.15 (SDA); also elsewhere on the board

Notes on the sheet:
W-05 | RTC DS3231SN + I2C OLED
NON-RECHARGEABLE
J3: 1=3V3 2=GND 3=SCL 4=SDA
Pin NC 5-12 ke GND sesuai datasheet
OLED SH1106 | J3 XH4 | BT1 1060TR
RTC 0x68 | I2C 3.3 V

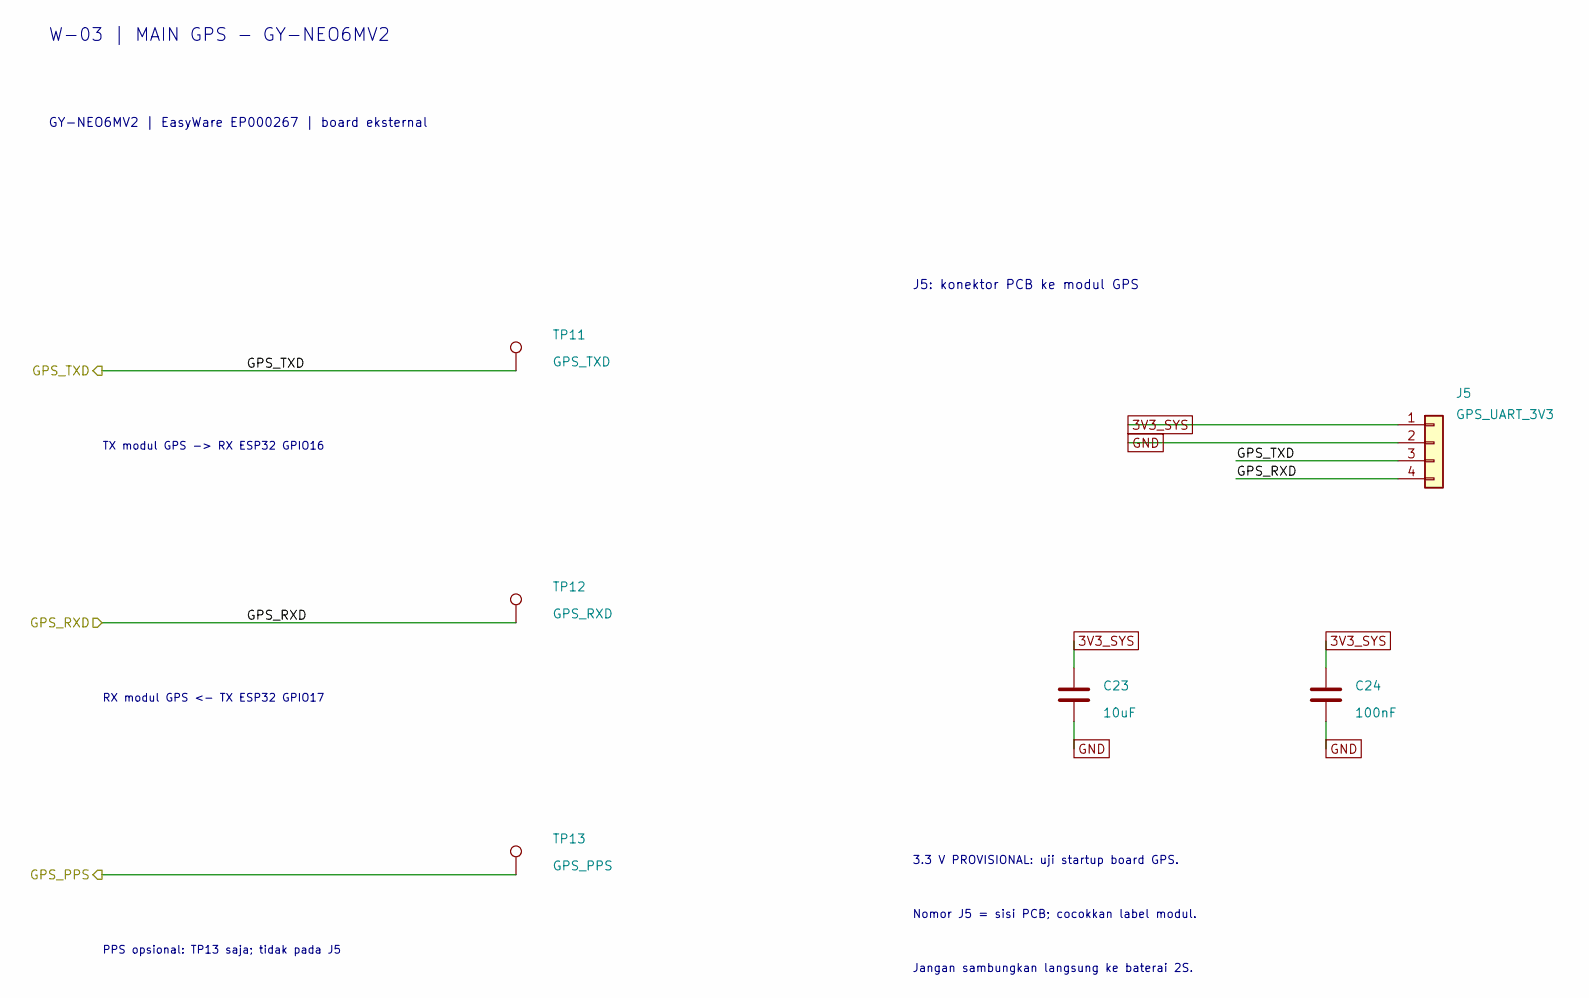
[picture p10: schematic main_coordinates.kicad_sch, MAIN GPS - GY-NEO6MV2 UART]

Parts:
C23: 10uF; C_0805_2012Metric; Voltage_Rating >=6.3V; MPN CL21A106KAYNNNE; LCSC Part # C15850
C24: 100nF; C_0805_2012Metric; Voltage_Rating >=6.3V; MPN C0805C104K5RACTU; LCSC Part # C3018562
J5: GPS_UART_3V3; JST_XH_B4B-XH-A_1x04_P2.50mm_Vertical; MPN B4B-XH-A(LF)(SN); LCSC Part # C144395
TP11: GPS_TXD; TestPoint_Pad_D1.5mm; MPN N/A - PCB copper feature
TP12: GPS_RXD; TestPoint_Pad_D1.5mm; MPN N/A - PCB copper feature
TP13: GPS_PPS; TestPoint_Pad_D1.5mm; MPN N/A - PCB copper feature

Connections:
3V3_SYS: C23.1, C24.1, J5.1; also elsewhere on the board
/MAIN_ESP32_PROGRAMMING/GPS_PPS: TP13.1 (1_1); also elsewhere on the board
/MAIN_ESP32_PROGRAMMING/GPS_RXD: J5.4, TP12.1 (1_1); also elsewhere on the board
/MAIN_ESP32_PROGRAMMING/GPS_TXD: J5.3, TP11.1 (1_1); also elsewhere on the board
GND: C23.2, C24.2, J5.2; also elsewhere on the board

Notes on the sheet:
GY-NEO6MV2 | EasyWare EP000267 | board eksternal
J5: konektor PCB ke modul GPS
RX modul GPS <- TX ESP32 GPIO17
PPS opsional: TP13 saja; tidak pada J5
W-03 | MAIN GPS - GY-NEO6MV2
TX modul GPS -> RX ESP32 GPIO16
3.3 V PROVISIONAL: uji startup board GPS.
Nomor J5 = sisi PCB; cocokkan label modul.
Jangan sambungkan langsung ke baterai 2S.

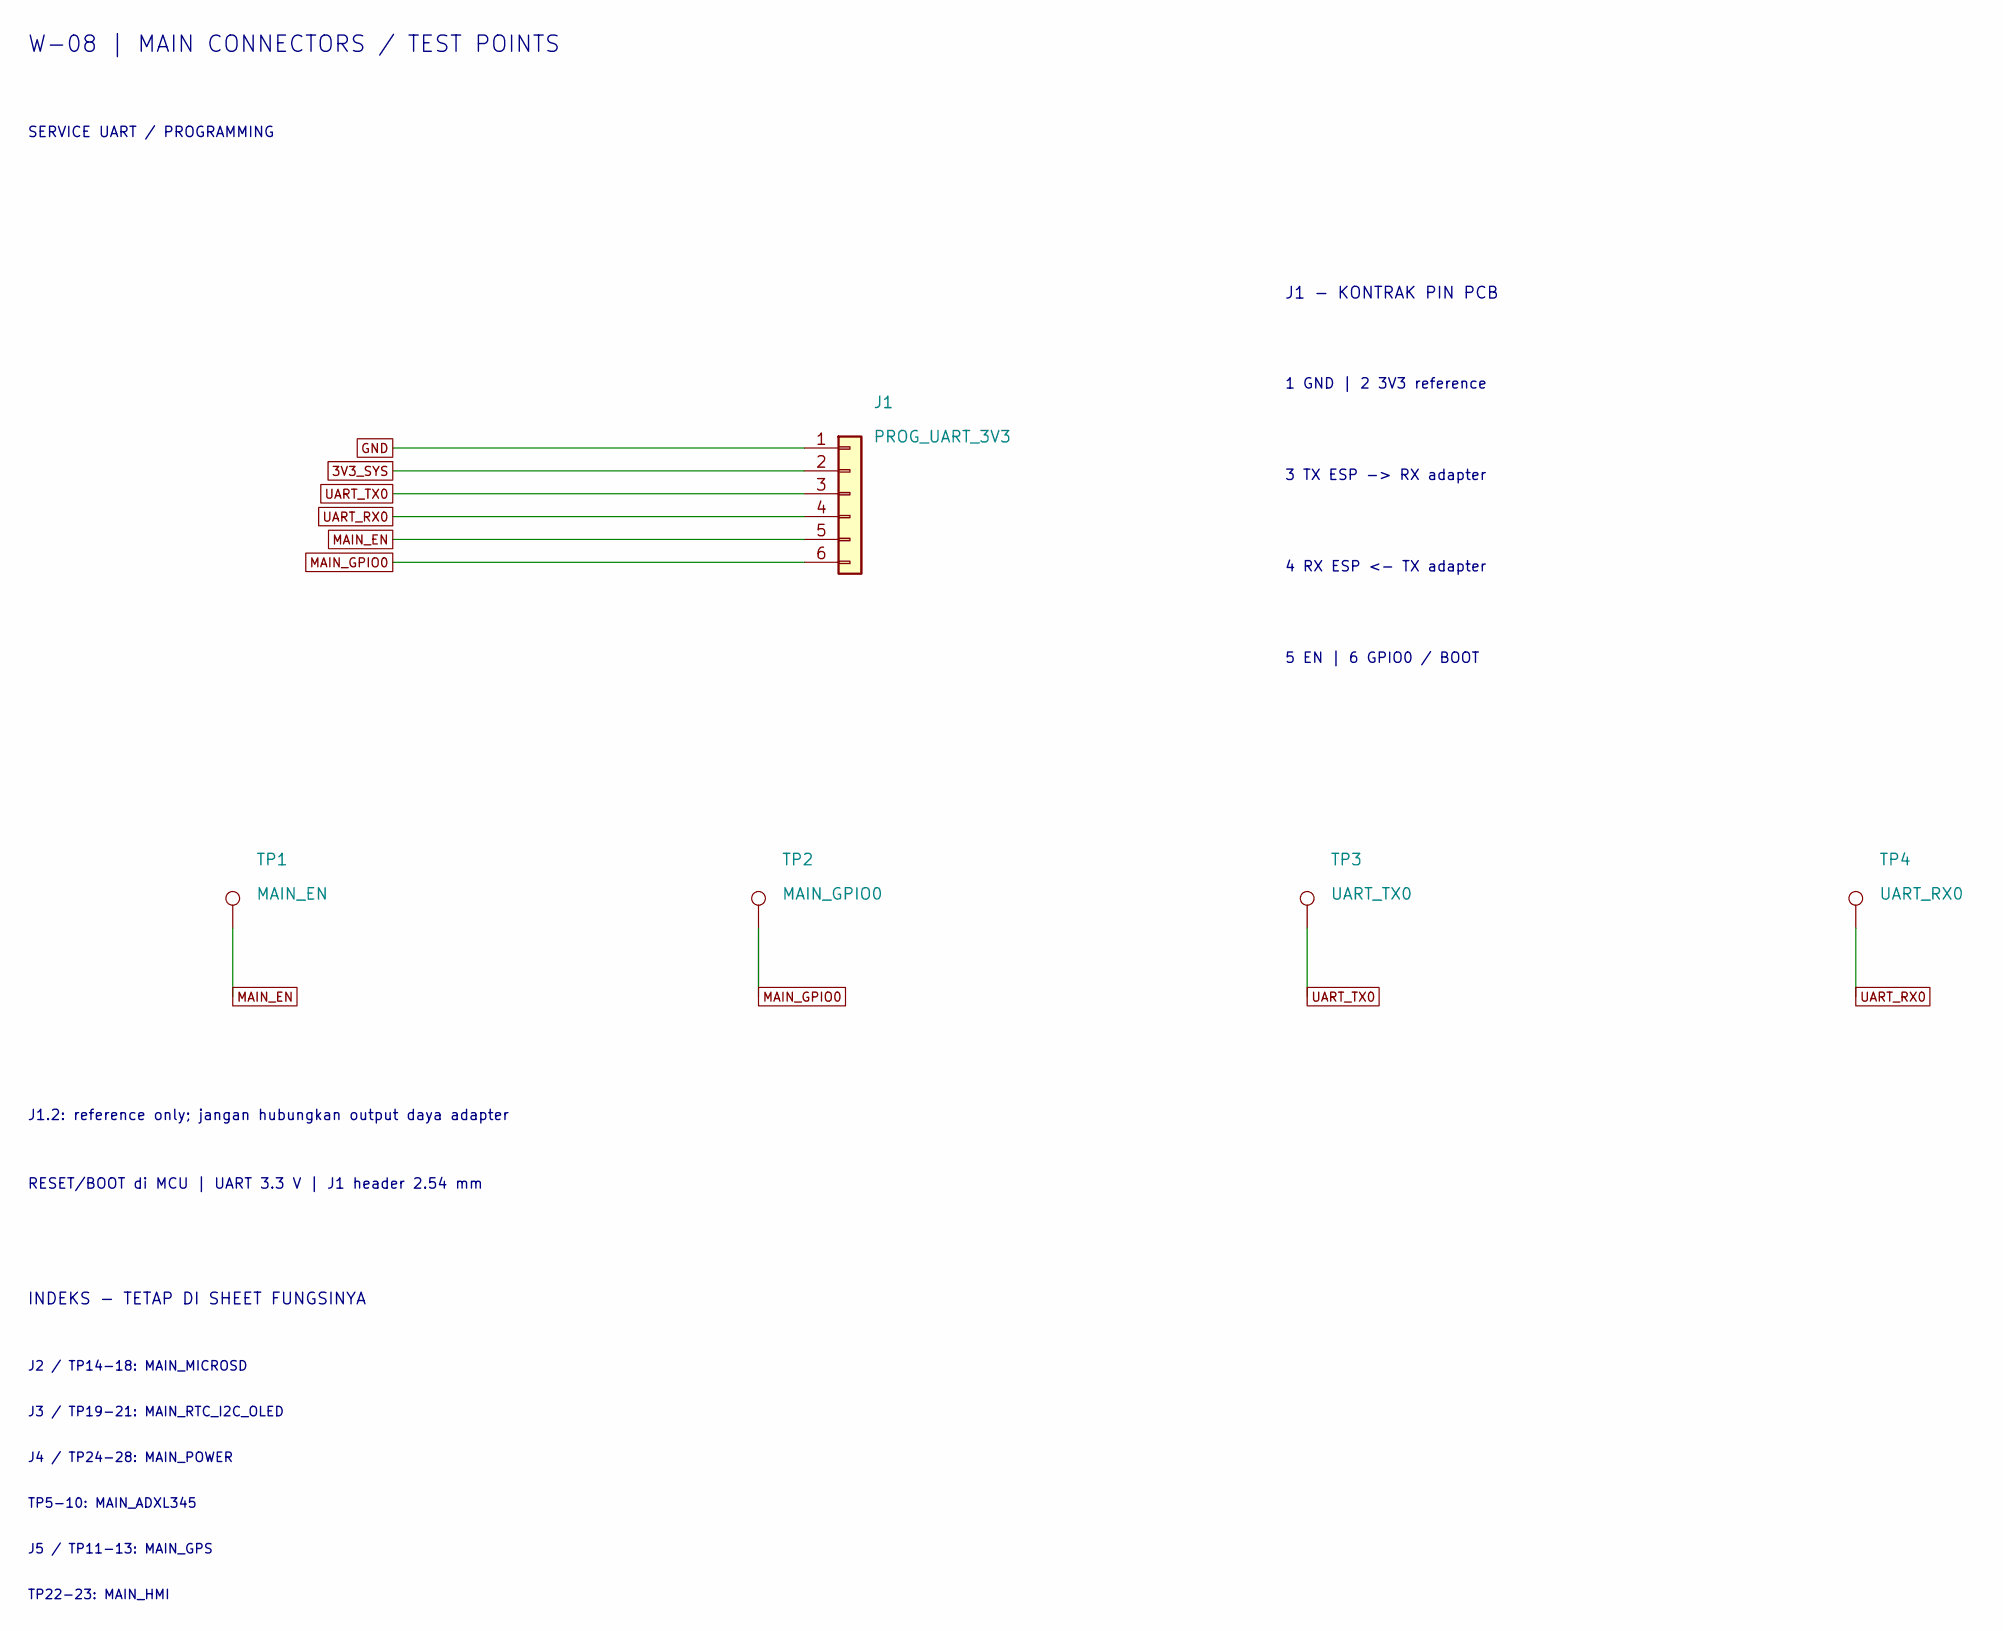
[picture p11: schematic main_connectors_testpoints.kicad_sch, MAIN CONNECTORS / TEST POINTS]

Parts:
J1: PROG_UART_3V3; PinHeader_1x06_P2.54mm_ZHOURI_1.02mm; MPN 2.54-1*6; LCSC Part # C5156615
TP1: MAIN_EN; TestPoint_Pad_D1.5mm; MPN N/A - PCB copper feature
TP2: MAIN_GPIO0; TestPoint_Pad_D1.5mm; MPN N/A - PCB copper feature
TP3: UART_TX0; TestPoint_Pad_D1.5mm; MPN N/A - PCB copper feature
TP4: UART_RX0; TestPoint_Pad_D1.5mm; MPN N/A - PCB copper feature

Connections:
3V3_SYS: J1.2; also elsewhere on the board
GND: J1.1; also elsewhere on the board
MAIN_EN: J1.5, TP1.1 (1_1); also elsewhere on the board
MAIN_GPIO0: J1.6, TP2.1 (1_1); also elsewhere on the board
UART_RX0: J1.4, TP4.1 (1_1); also elsewhere on the board
UART_TX0: J1.3, TP3.1 (1_1); also elsewhere on the board

Notes on the sheet:
W-08 | MAIN CONNECTORS / TEST POINTS
1 GND | 2 3V3 reference
J4 / TP24-28: MAIN_POWER
RESET/BOOT di MCU | UART 3.3 V | J1 header 2.54 mm
SERVICE UART / PROGRAMMING
3 TX ESP -> RX adapter
TP5-10: MAIN_ADXL345
J1.2: reference only; jangan hubungkan output daya adapter
J1 - KONTRAK PIN PCB
J3 / TP19-21: MAIN_RTC_I2C_OLED
J2 / TP14-18: MAIN_MICROSD
4 RX ESP <- TX adapter
TP22-23: MAIN_HMI
J5 / TP11-13: MAIN_GPS
INDEKS - TETAP DI SHEET FUNGSINYA
5 EN | 6 GPIO0 / BOOT

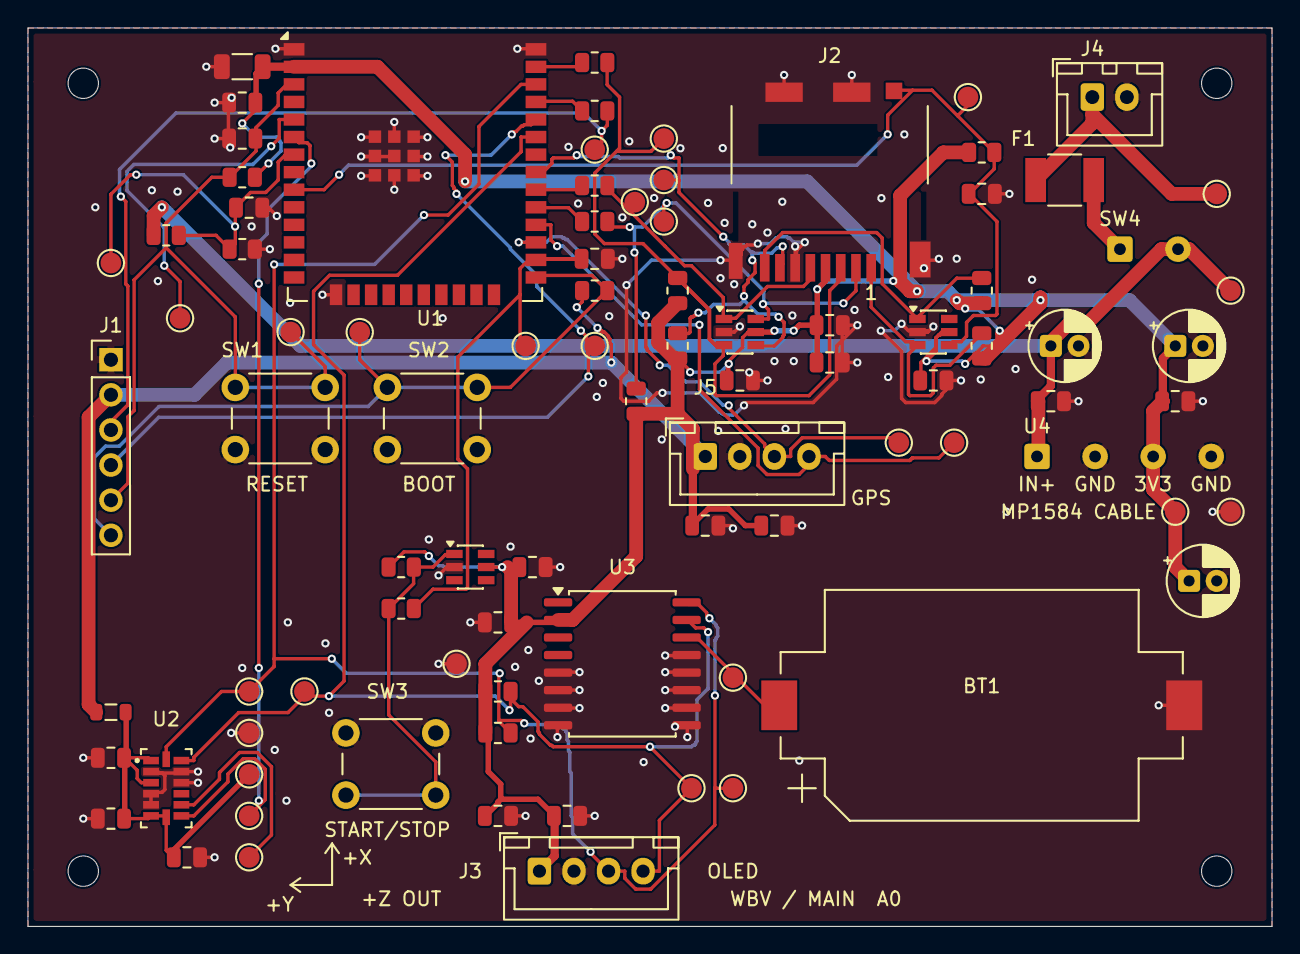
[picture p12: board main_unit.kicad_pcb from above]

Board: 2 copper layers, 90.0 x 65.0 mm, 93 parts (0 on the bottom side), 32 nets.

Other parts of the board:
H1, H2, H3, H4: M2 mounting PROVISIONAL; MountingHole_2.2mm_M2
