Dritzz7/hardware-dosimeter/hav_node/hav_node.kicad_pcb

## KiCad design hav_node/hav_node.kicad_pcb (2026-10-11)

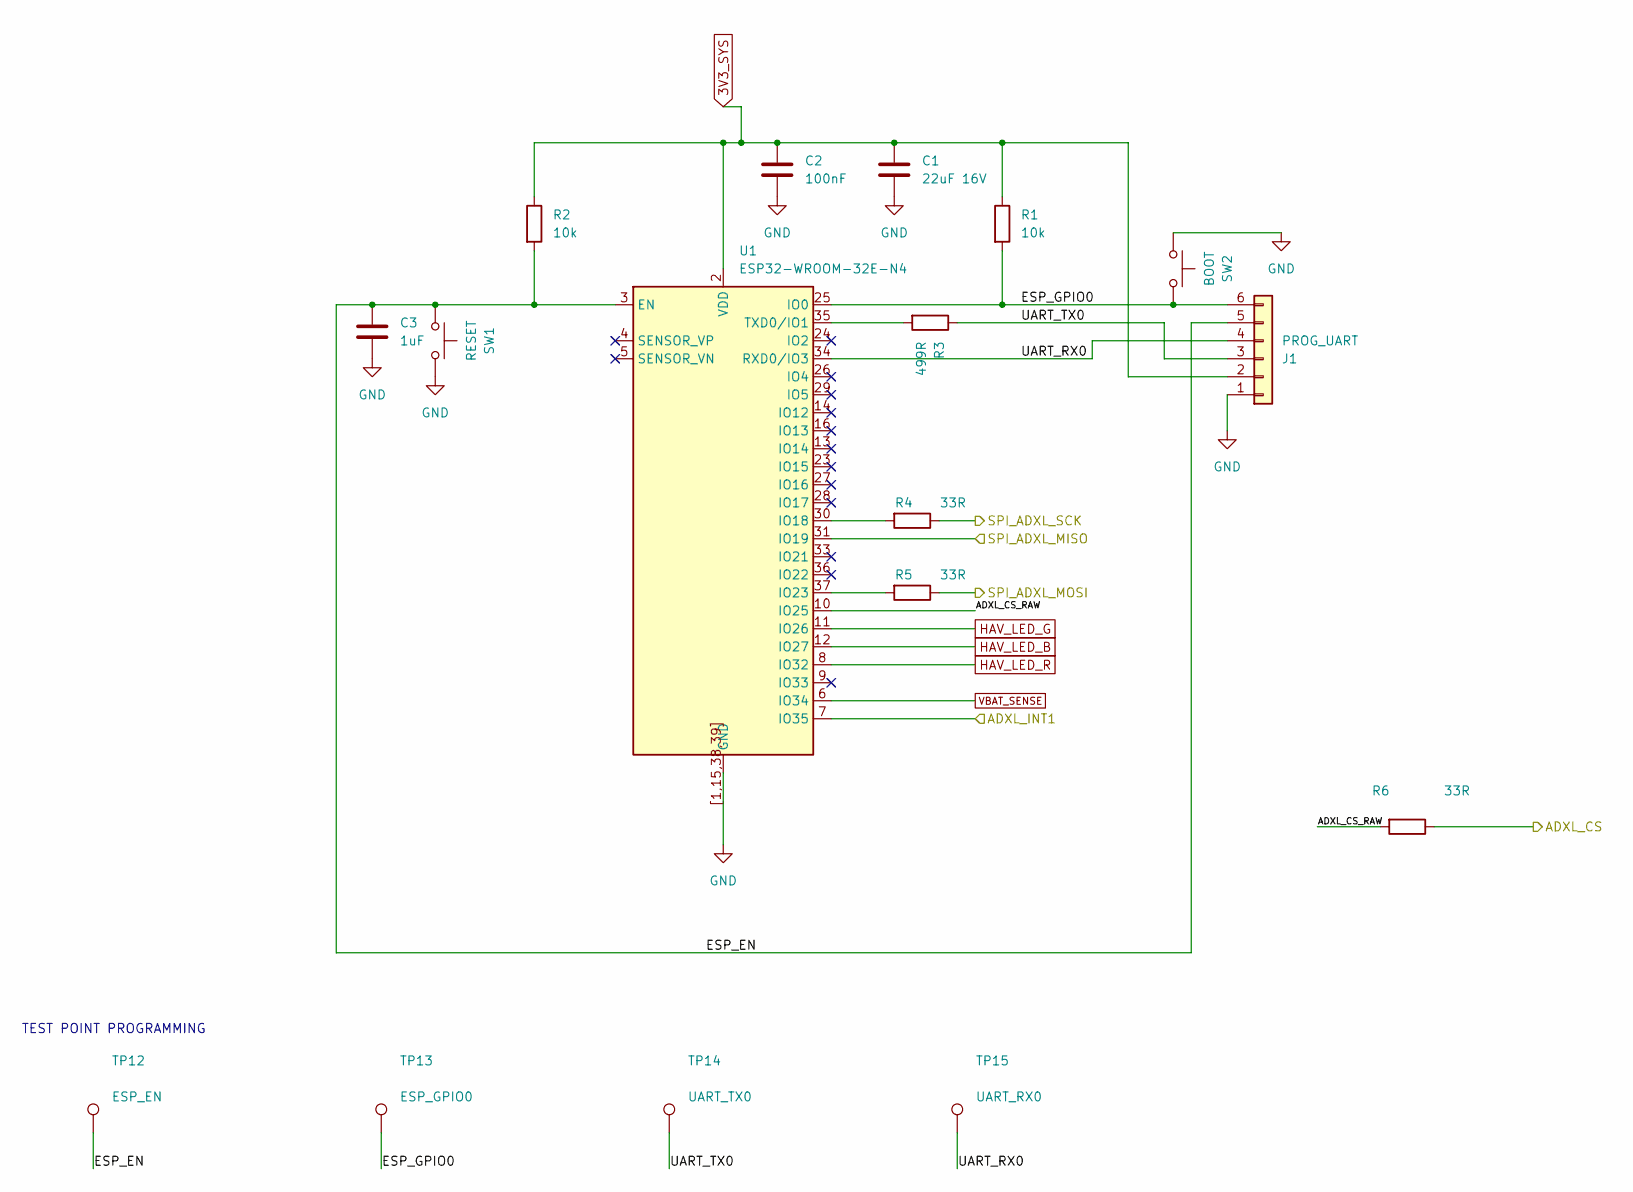
[picture p13: schematic hav_esp32_programming.kicad_sch]

Parts:
C1: 22uF 16V; C_1206_3216Metric; MPN CL31A226KOHNNNE; LCSC Part # C90146
C2: 100nF; C_0805_2012Metric; MPN C0805C104K5RACTU; LCSC Part # C3018562
C3: 1uF; C_0805_2012Metric; MPN C0805C105K4RACTU; LCSC Part # C2167376
J1: PROG_UART; PinHeader_1x06_P2.54mm_ZHOURI_1.02mm; MPN 2.54-1*6; LCSC Part # C5156615
R1, R2: 10k; R_0805_2012Metric; MPN RC0805FR-0710KL; LCSC Part # C84376
R3: 499R; R_0805_2012Metric; MPN RC0805FR-07499RL; LCSC Part # C130458
R4, R5, R6: 33R; R_0805_2012Metric; MPN RC0805FR-0733RL; LCSC Part # C126353
SW1: RESET; SW_PUSH_6mm_H4.3mm; MPN B3F-1000; LCSC Part # C93157
SW2: BOOT; SW_PUSH_6mm_H4.3mm; MPN B3F-1000; LCSC Part # C93157
TP12: ESP_EN; TestPoint_Pad_D1.5mm; MPN N/A - bare PCB pad
TP13: ESP_GPIO0; TestPoint_Pad_D1.5mm; MPN N/A - bare PCB pad
TP14: UART_TX0; TestPoint_Pad_D1.5mm; MPN N/A - bare PCB pad
TP15: UART_RX0; TestPoint_Pad_D1.5mm; MPN N/A - bare PCB pad
U1: ESP32-WROOM-32E-N4; ESP32-WROOM-32E_JLC_NoVia; MPN ESP32-WROOM-32E-N4; LCSC Part # C701341

Connections:
3V3_SYS: C1.1, C2.1, J1.2, R1.1, R2.1, U1.2 (VDD); also elsewhere on the board
/ADXL_CS: R6.1; also elsewhere on the board
/ADXL_INT1: U1.7 (IO35); also elsewhere on the board
/HAV_ESP32_PROGRAMMING/ADXL_CS_RAW: R6.2, U1.10 (IO25)
/HAV_ESP32_PROGRAMMING/ESP_EN: C3.1, J1.5, R2.2, SW1.1, TP12.1 (1_1), U1.3 (EN)
/HAV_ESP32_PROGRAMMING/ESP_GPIO0: J1.6, R1.2, SW2.2, TP13.1 (1_1), U1.25 (IO0)
/HAV_ESP32_PROGRAMMING/UART_RX0: J1.4, TP15.1 (1_1), U1.34 (RXD0/IO3)
/HAV_ESP32_PROGRAMMING/UART_TX0: J1.3, R3.1, TP14.1 (1_1)
/SPI_ADXL_MISO: U1.31 (IO19); also elsewhere on the board
/SPI_ADXL_MOSI: R5.1; also elsewhere on the board
/SPI_ADXL_SCK: R4.1; also elsewhere on the board
GND: C1.2, C2.2, C3.2, J1.1, SW1.2, SW2.1, U1.1 (GND), U1.15 (GND), U1.38 (GND), U1.39 (GND), U1.[1,15,38,39] (GND); also elsewhere on the board
HAV_LED_B: U1.12 (IO27); also elsewhere on the board
HAV_LED_G: U1.11 (IO26); also elsewhere on the board
HAV_LED_R: U1.8 (IO32); also elsewhere on the board
unnamed: R4.2, U1.30 (IO18)
unnamed: R5.2, U1.37 (IO23)
unnamed: R3.2, U1.35 (TXD0/IO1)
VBAT_SENSE: U1.6 (IO34); also elsewhere on the board

Notes on the sheet:
TEST POINT PROGRAMMING

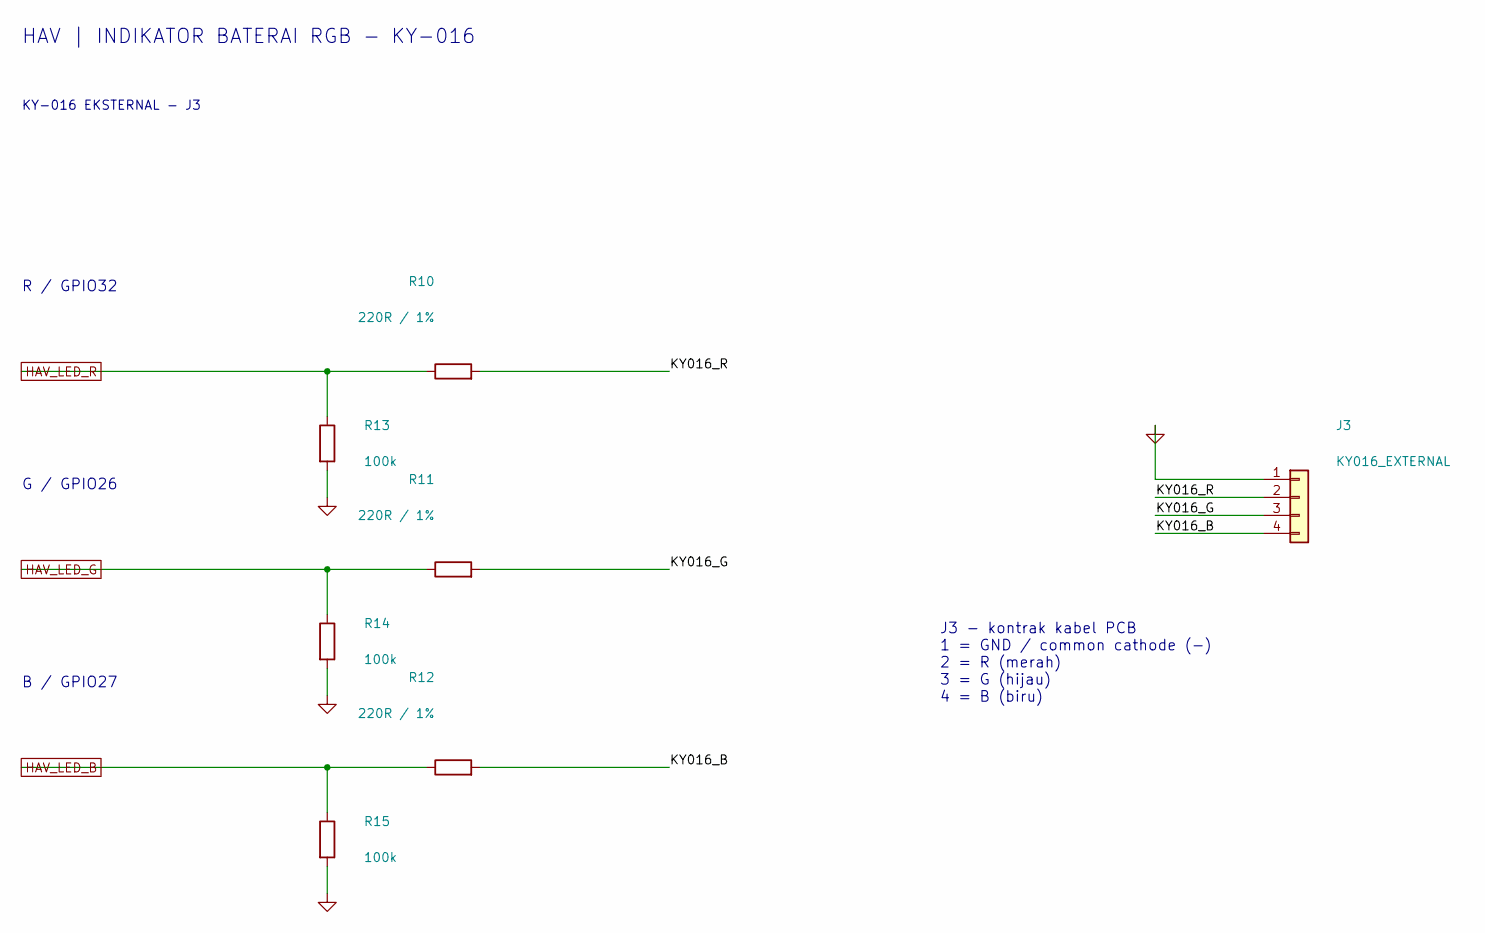
[picture p14: schematic hav_connectors_testpoints.kicad_sch, HAV - KY016 BATTERY INDICATOR]

Parts:
J3: KY016_EXTERNAL; JST_XH_B4B-XH-A_1x04_P2.50mm_Vertical; MPN B4B-XH-A(LF)(SN); LCSC Part # C144395
R10, R11, R12: 220R / 1%; R_0805_2012Metric; MPN RC0805FR-07220RL; LCSC Part # C114519
R13, R14, R15: 100k; R_0805_2012Metric; MPN RC0805FR-07100KL; LCSC Part # C96346

Connections:
/HAV_CONNECTORS_TESTPOINTS/KY016_B: J3.4, R12.2
/HAV_CONNECTORS_TESTPOINTS/KY016_G: J3.3, R11.2
/HAV_CONNECTORS_TESTPOINTS/KY016_R: J3.2, R10.2
GND: J3.1, R13.2, R14.2, R15.2; also elsewhere on the board
HAV_LED_B: R12.1, R15.1; also elsewhere on the board
HAV_LED_G: R11.1, R14.1; also elsewhere on the board
HAV_LED_R: R10.1, R13.1; also elsewhere on the board

Notes on the sheet:
KY-016 EKSTERNAL - J3
G / GPIO26
J3 - kontrak kabel PCB 1 = GND / common cathode (-) 2 = R (merah) 3 = G (hijau) 4 = B (biru)
HAV | INDIKATOR BATERAI RGB - KY-016
B / GPIO27
R / GPIO32

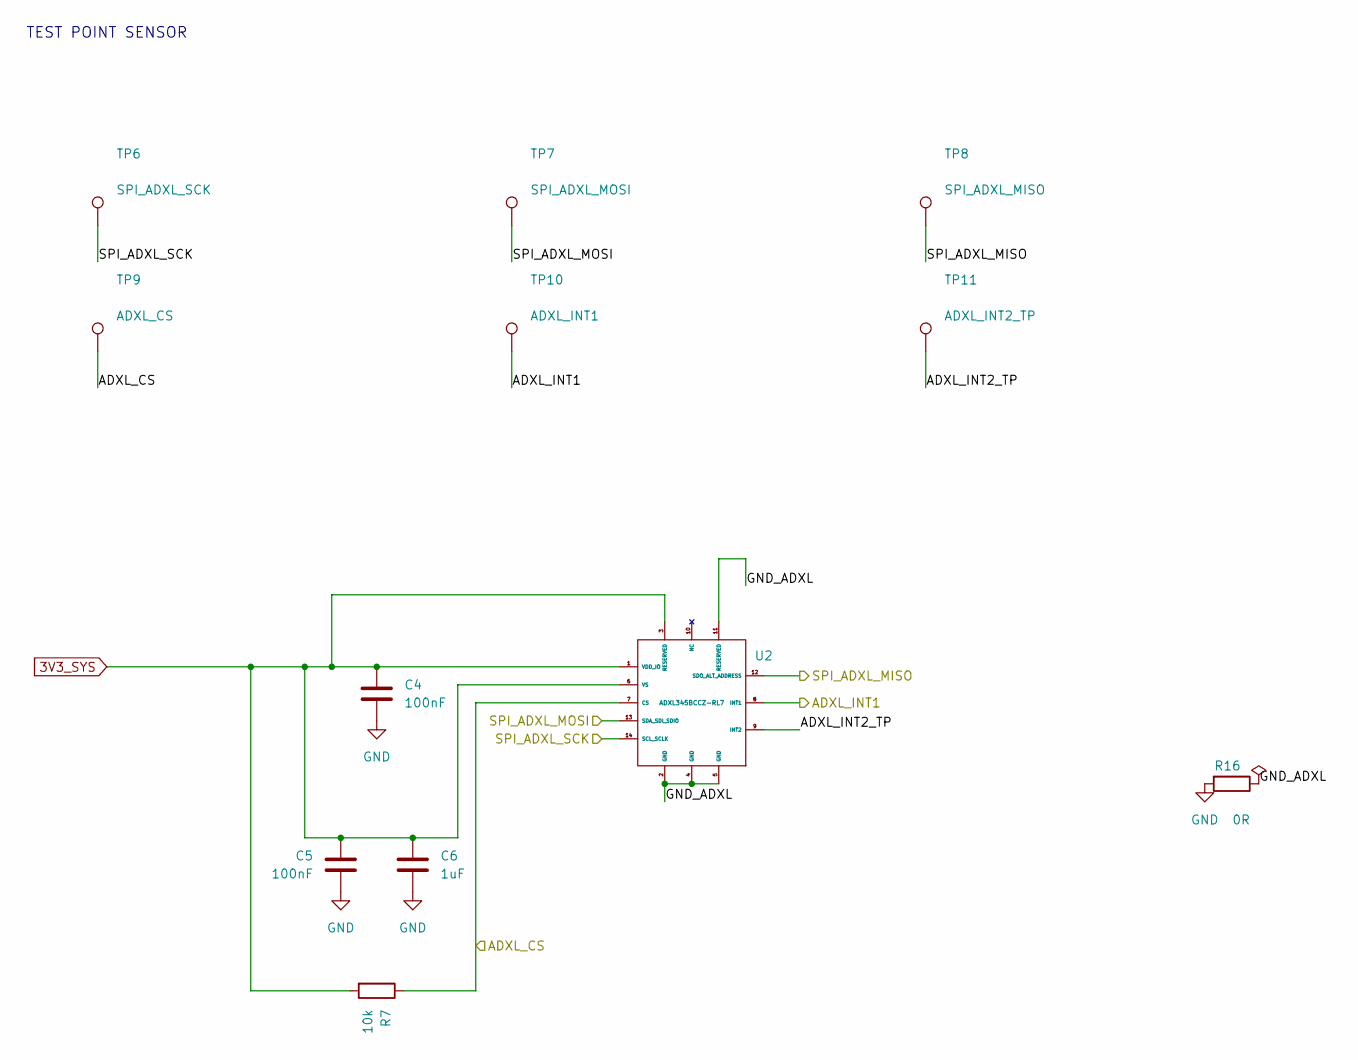
[picture p15: schematic hav_adxl345.kicad_sch]

Parts:
C4, C5: 100nF; C_0805_2012Metric; MPN C0805C104K5RACTU; LCSC Part # C3018562
C6: 1uF; C_0805_2012Metric; MPN C0805C105K4RACTU; LCSC Part # C2167376
R7: 10k; R_0805_2012Metric; MPN RC0805FR-0710KL; LCSC Part # C84376
R16: 0R; R_0805_2012Metric; MPN RC0805JR-070RL; LCSC Part # C96345
TP6: SPI_ADXL_SCK; TestPoint_Pad_D1.5mm; MPN N/A - bare PCB pad
TP7: SPI_ADXL_MOSI; TestPoint_Pad_D1.5mm; MPN N/A - bare PCB pad
TP8: SPI_ADXL_MISO; TestPoint_Pad_D1.5mm; MPN N/A - bare PCB pad
TP9: ADXL_CS; TestPoint_Pad_D1.5mm; MPN N/A - bare PCB pad
TP10: ADXL_INT1; TestPoint_Pad_D1.5mm; MPN N/A - bare PCB pad
TP11: ADXL_INT2_TP; TestPoint_Pad_D1.5mm; MPN N/A - bare PCB pad
U2: ADXL345BCCZ-RL7; ADXL345_CC-14-1_ADI_JLC; MPN ADXL345BCCZ-RL7; LCSC Part # C9667

Connections:
3V3_SYS: C4.1, C5.1, C6.1, R7.2, U2.1 (VDD_IO), U2.3 (RESERVED), U2.6 (VS); also elsewhere on the board
/ADXL_CS: R7.1, TP9.1 (1_1), U2.7 (CS); also elsewhere on the board
/ADXL_INT1: TP10.1 (1_1), U2.8 (INT1); also elsewhere on the board
/HAV_ADXL345/ADXL_INT2_TP: TP11.1 (1_1), U2.9 (INT2)
/HAV_ADXL345/GND_ADXL: R16.1, U2.2 (GND), U2.4 (GND), U2.5 (GND), U2.11 (RESERVED)
/SPI_ADXL_MISO: TP8.1 (1_1), U2.12 (SDO_ALT_ADDRESS); also elsewhere on the board
/SPI_ADXL_MOSI: TP7.1 (1_1), U2.13 (SDA_SDI_SDIO); also elsewhere on the board
/SPI_ADXL_SCK: TP6.1 (1_1), U2.14 (SCL_SCLK); also elsewhere on the board
GND: C4.2, C5.2, C6.2, R16.2; also elsewhere on the board

Notes on the sheet:
TEST POINT SENSOR

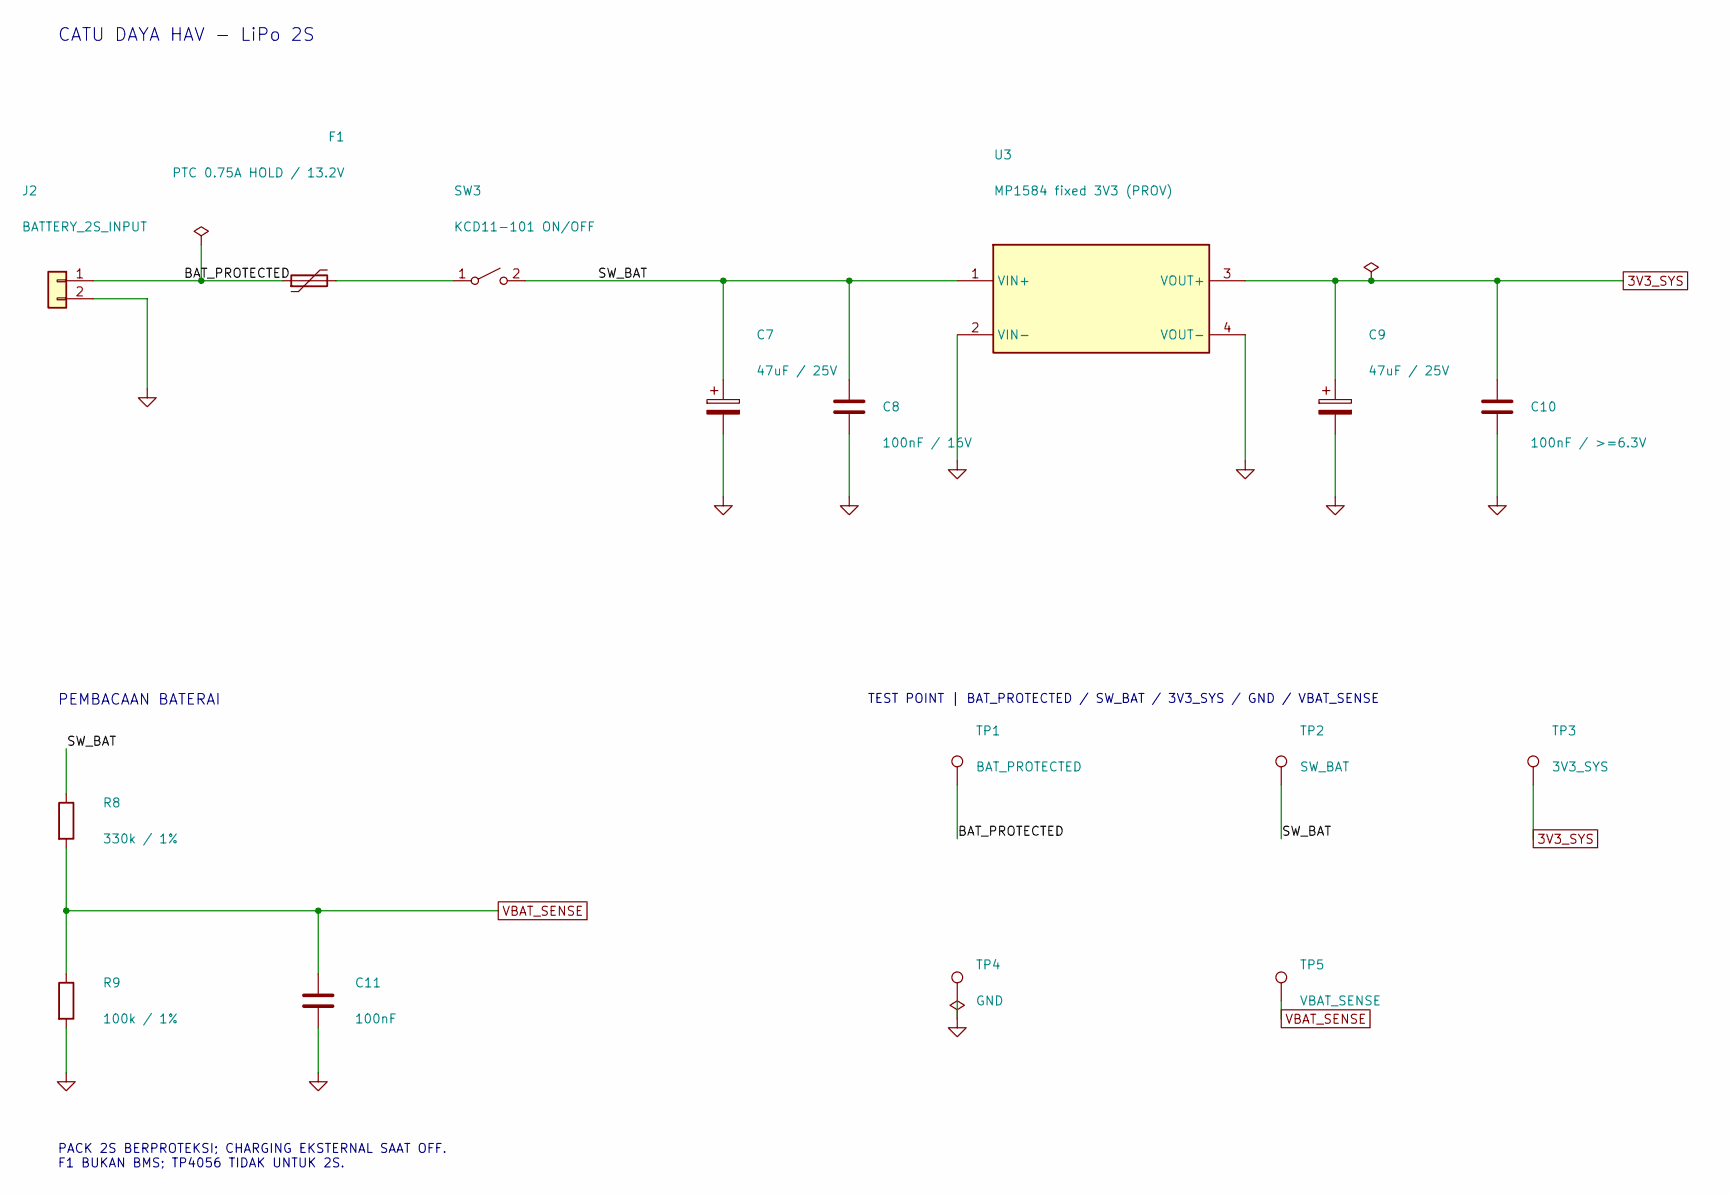
[picture p16: schematic hav_power.kicad_sch, HAV POWER]

Parts:
C7, C9: 47uF / 25V; CP_Radial_D5.0mm_P2.00mm_H11mm_Panasonic_FR; MPN EEUFR1E470; LCSC Part # C407893
C8: 100nF / 16V; C_0805_2012Metric; MPN C0805C104K5RACTU; LCSC Part # C3018562
C10: 100nF / >=6.3V; C_0805_2012Metric; MPN C0805C104K5RACTU; LCSC Part # C3018562
C11: 100nF; C_0805_2012Metric; MPN C0805C104K5RACTU; LCSC Part # C3018562
F1: PTC 0.75A HOLD / 13.2V; Fuse_Bourns_MF-MSMF075_1812_Style1; MPN MF-MSMF075-2; LCSC Part # C84140
J2: BATTERY_2S_INPUT; JST_XH_B2B-XH-A_1x02_P2.50mm_Vertical; MPN B2B-XH-A(LF)(SN); LCSC Part # C158012
R8: 330k / 1%; R_0805_2012Metric; MPN RC0805FR-07330KL; LCSC Part # C114528
R9: 100k / 1%; R_0805_2012Metric; MPN RC0805FR-07100KL; LCSC Part # C96346
SW3: KCD11-101 ON/OFF; SolderWire-0.25sqmm_1x02_P4.2mm_D0.65mm_OD1.7mm; MPN OPEN - verify purchased part
TP1: BAT_PROTECTED; TestPoint_Pad_D1.5mm; MPN N/A - bare PCB pad
TP2: SW_BAT; TestPoint_Pad_D1.5mm; MPN N/A - bare PCB pad
TP3: 3V3_SYS; TestPoint_Pad_D1.5mm; MPN N/A - bare PCB pad
TP4: GND; TestPoint_Pad_D1.5mm; MPN N/A - bare PCB pad
TP5: VBAT_SENSE; TestPoint_Pad_D1.5mm; MPN N/A - bare PCB pad
U3: MP1584 fixed 3V3 (PROV); SolderWire-0.25sqmm_1x04_P4.2mm_D0.65mm_OD1.7mm; MPN OPEN - verify purchased part

Connections:
3V3_SYS: C9.1, C10.1, TP3.1 (1_1), U3.3 (VOUT+); also elsewhere on the board
/HAV_POWER/BAT_PROTECTED: F1.1, J2.1, TP1.1 (1_1)
/HAV_POWER/SW_BAT: C7.1, C8.1, R8.1, SW3.2 (B), TP2.1 (1_1), U3.1 (VIN+)
GND: C7.2, C8.2, C9.2, C10.2, C11.2, J2.2, R9.2, TP4.1 (1_1), U3.2 (VIN-), U3.4 (VOUT-); also elsewhere on the board
unnamed: F1.2, SW3.1 (A)
VBAT_SENSE: C11.1, R8.2, R9.1, TP5.1 (1_1); also elsewhere on the board

Notes on the sheet:
CATU DAYA HAV - LiPo 2S
PEMBACAAN BATERAI
TEST POINT | BAT_PROTECTED / SW_BAT / 3V3_SYS / GND / VBAT_SENSE
PACK 2S BERPROTEKSI; CHARGING EKSTERNAL SAAT OFF. F1 BUKAN BMS; TP4056 TIDAK UNTUK 2S.
