Dritzz7/hardware-dosimeter/hav_node/hav_node.kicad_pcb

## KiCad design hav_node/hav_node.kicad_pcb (continued)

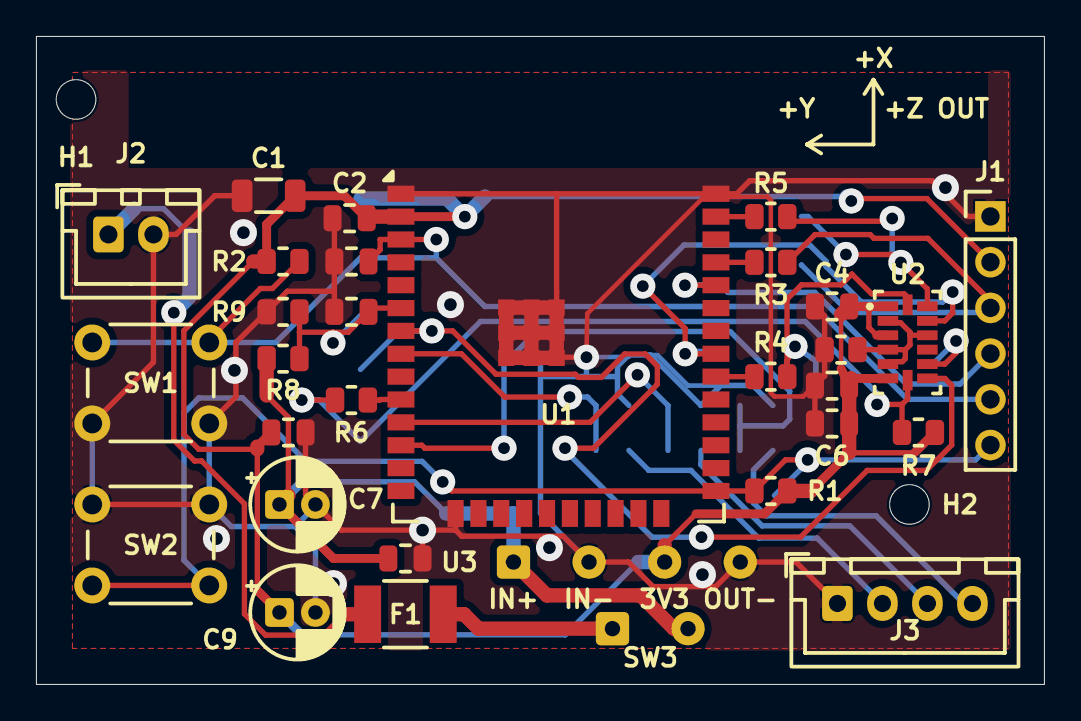
[picture p17: board hav_node.kicad_pcb from above]

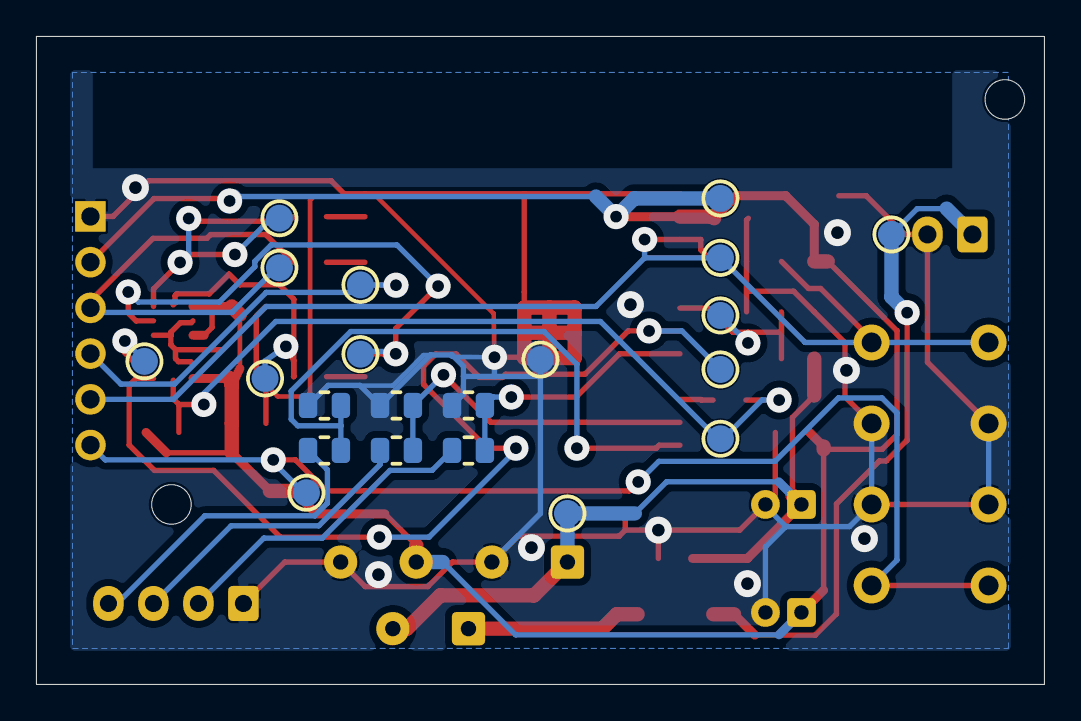
[picture p18: board hav_node.kicad_pcb from below]

Board: 2 copper layers, 56.0 x 36.0 mm, 54 parts (21 on the bottom side), 27 nets.

Other parts of the board:
H1, H2: M2 mounting; MountingHole_2.2mm_M2_BothSides
