Dritzz7/hardware-dosimeter/(commit log)

2026-09-28 First upload
    [hav_adxl345.kicad_sch, hav_connectors_testpoints.kicad_sch, hav_esp32_programming.kicad_sch, hav_node.kicad_pcb, hav_node.kicad_sch, hav_power.kicad_sch]
2026-09-29 Update skematik dan PCB HAV serta library custom
    [hav_adxl345.kicad_sch, hav_node.kicad_pcb, hav_power.kicad_sch]
2026-09-30 Rapihin skematik HAV
    [hav_adxl345.kicad_sch, hav_connectors_testpoints.kicad_sch, hav_esp32_programming.kicad_sch, hav_node.kicad_sch, hav_power.kicad_sch]
2026-10-02 HAV: final CAD check and cleanup 2026-10-02
    [hav_node.kicad_pcb]
2026-10-05 Add main unit
    [main_adxl345.kicad_sch, main_connectors_testpoints.kicad_sch, main_coordinates.kicad_sch, main_esp32_programming.kicad_sch, main_hmi.kicad_sch, main_microsd.kicad_sch, main_power.kicad_sch, main_rtc_i2c_oled.kicad_sch]
2026-10-11 Sync HAV and WBV KiCad sources with JLCPCB review packages
2026-10-11 Fix WBV RTC I2C routing and publish JLCPCB R2 package
